SmartEVSE/smartevse/pictures/smartevse_cli_ttl_cable.jpg

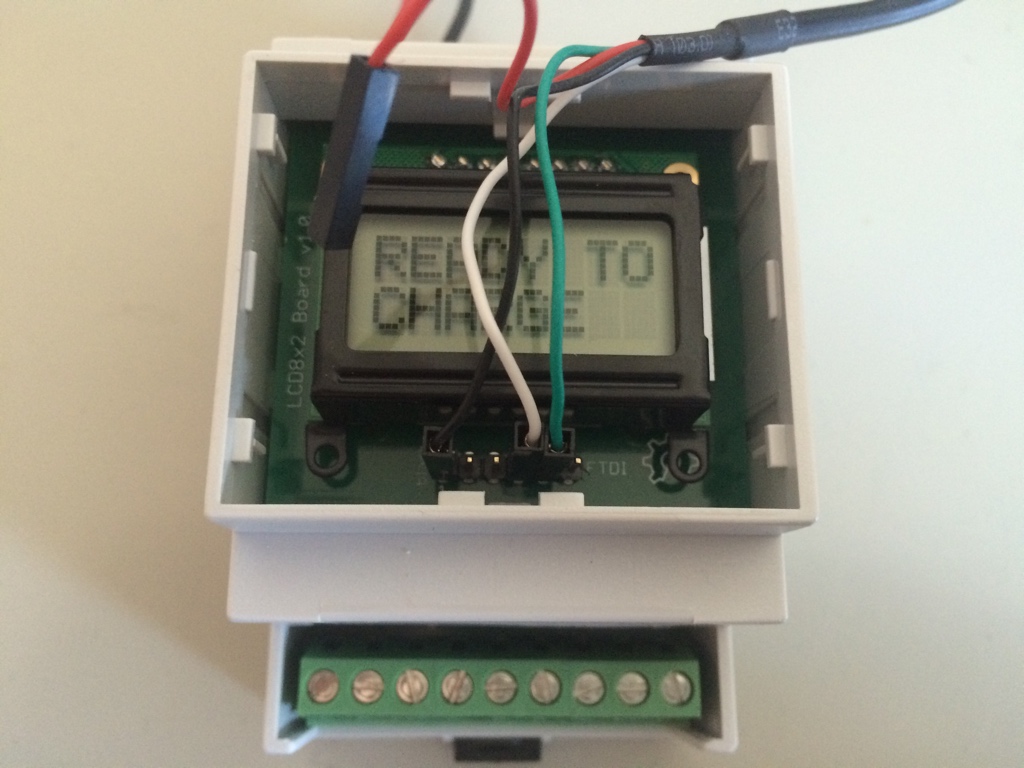
pictures/smartevse_cli_ttl_cable.jpg
