SmartEVSE/smartevse/pictures/EVSE_enclosure.jpg

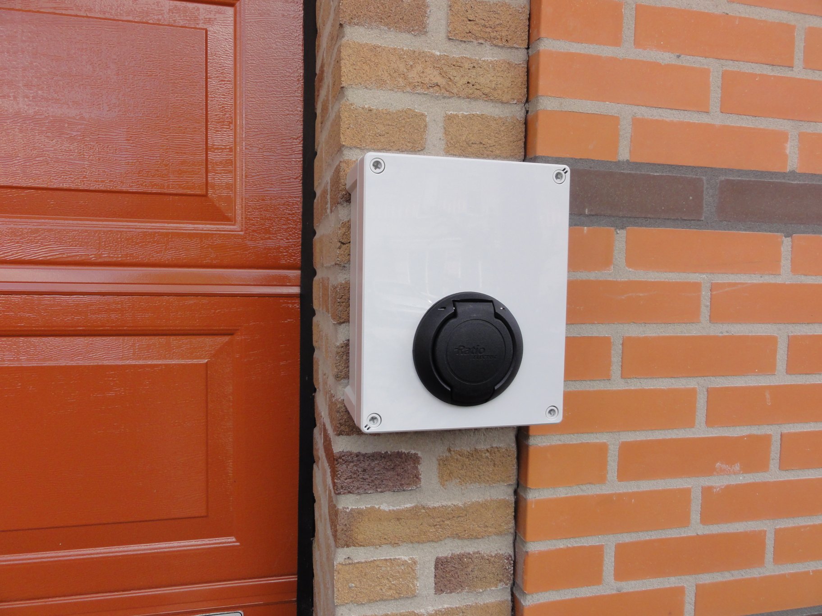
pictures/EVSE_enclosure.jpg
