SmartEVSE/smartevse/README.md

SmartEVSE v1
=========

This repository is now for the older v1 of the module only.
All developement for the current version v2 of the module is taking place here:
[SmartEVSE-2](https://github.com/SmartEVSE/SmartEVSE-2)
