SmartEVSE/smartevse/version2/README.md

SmartEVSE v2
=========

Version 2 uses a PIC 18F26K22 microcontroller, Graphic 128x64 LCD.
for compiling, MPLAB X IDE is used together with the XC8 compiler.

set XC8 linker memory model settings to: double 32 bit, float 32 bit
    extended instruction set is not used on XC8
	
- SmartEVSE2.X folder contains the sourcecode for the PIC microcontroller
- eagle folder holds the pcb layouts (eagle 6.6)
- manual folder has the latest manual.
