SmartEVSE/smartevse/pictures/1Phase_Charging26A.jpg

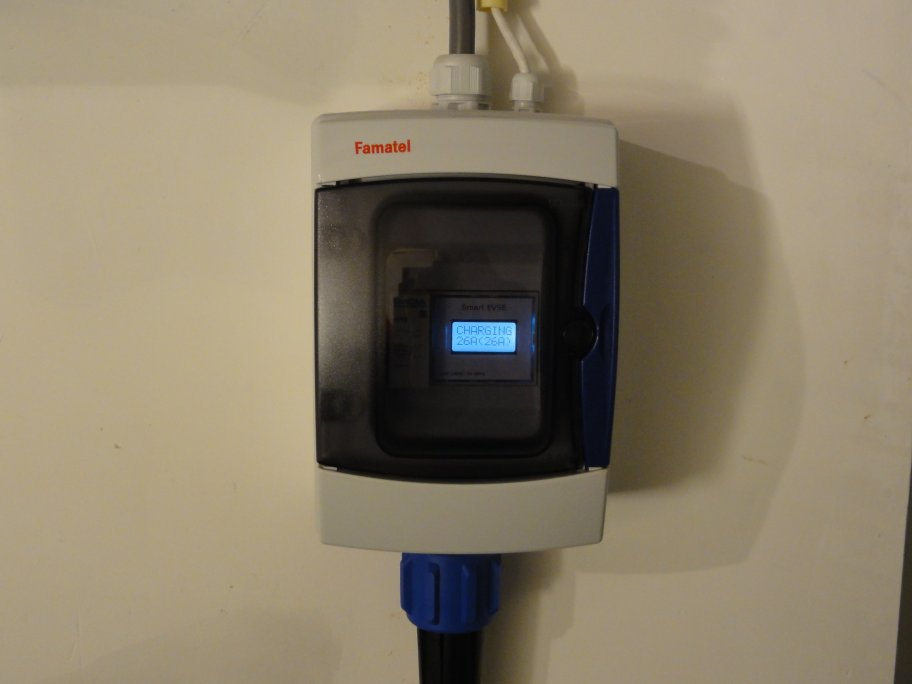
pictures/1Phase_Charging26A.jpg
