SmartEVSE/smartevse/pictures/1Phase_ChargingL123.jpg

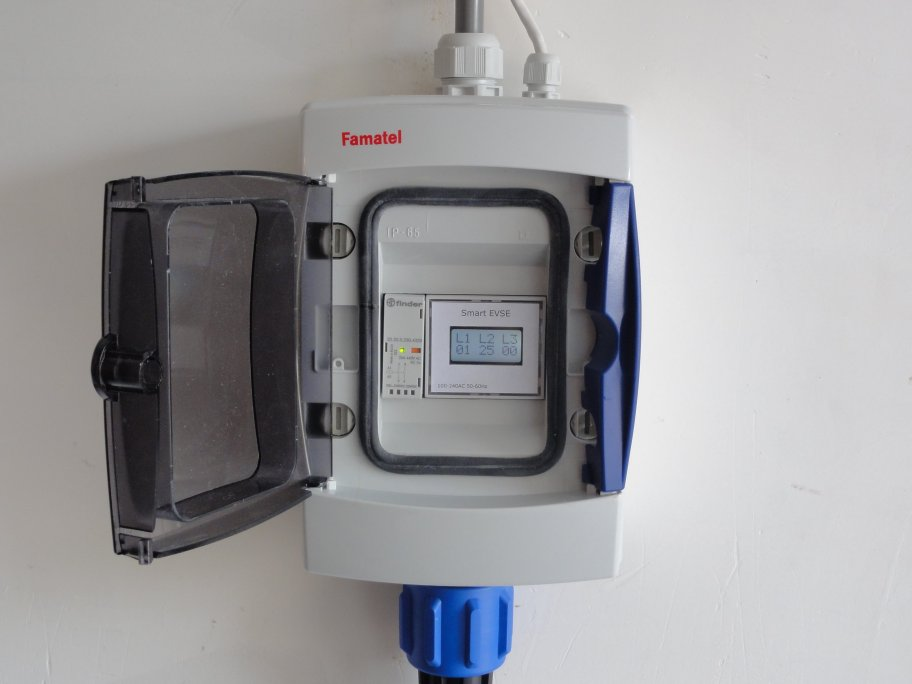
pictures/1Phase_ChargingL123.jpg
