SmartEVSE/smartevse/pictures/EVSE_enclosure_opened.jpg

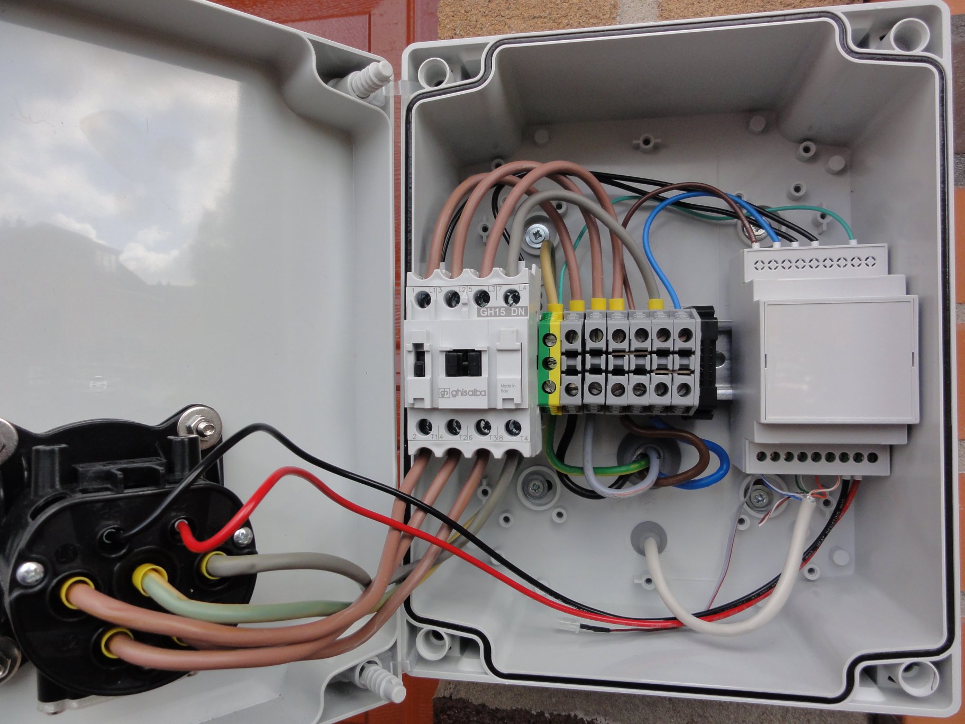
pictures/EVSE_enclosure_opened.jpg
