SmartEVSE/smartevse/pictures/LCD_menu.jpg

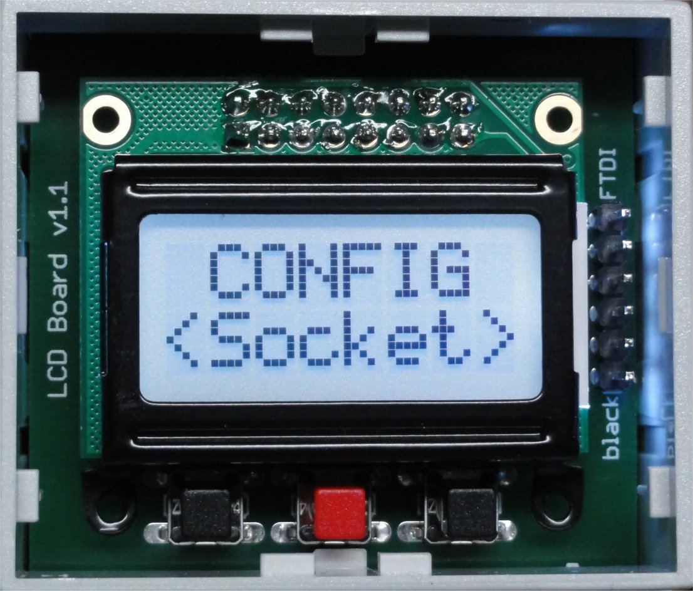
pictures/LCD_menu.jpg
