SmartEVSE/smartevse/pictures/sensorbox_opened.jpg

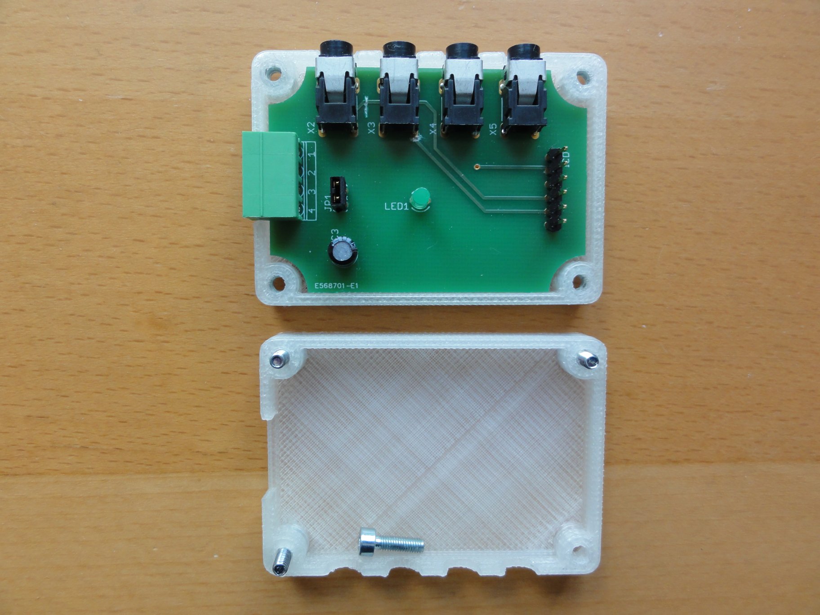
pictures/sensorbox_opened.jpg
