SmartEVSE/smartevse/pictures/smartevse_cli.png

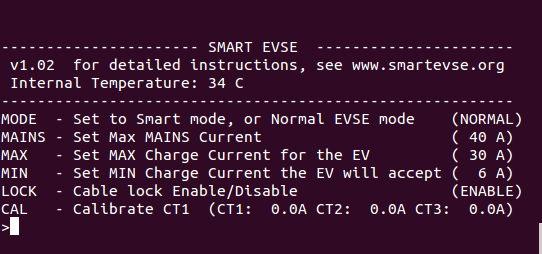
pictures/smartevse_cli.png
