SmartEVSE/smartevse/pictures/SmartEVSE_DIN.jpg

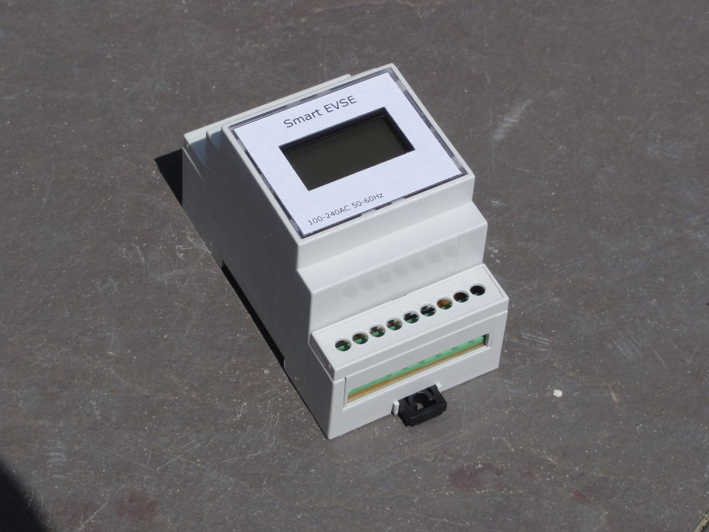
pictures/SmartEVSE_DIN.jpg
