SmartEVSE/smartevse/pictures/SmartEVSE_PCBa.jpg

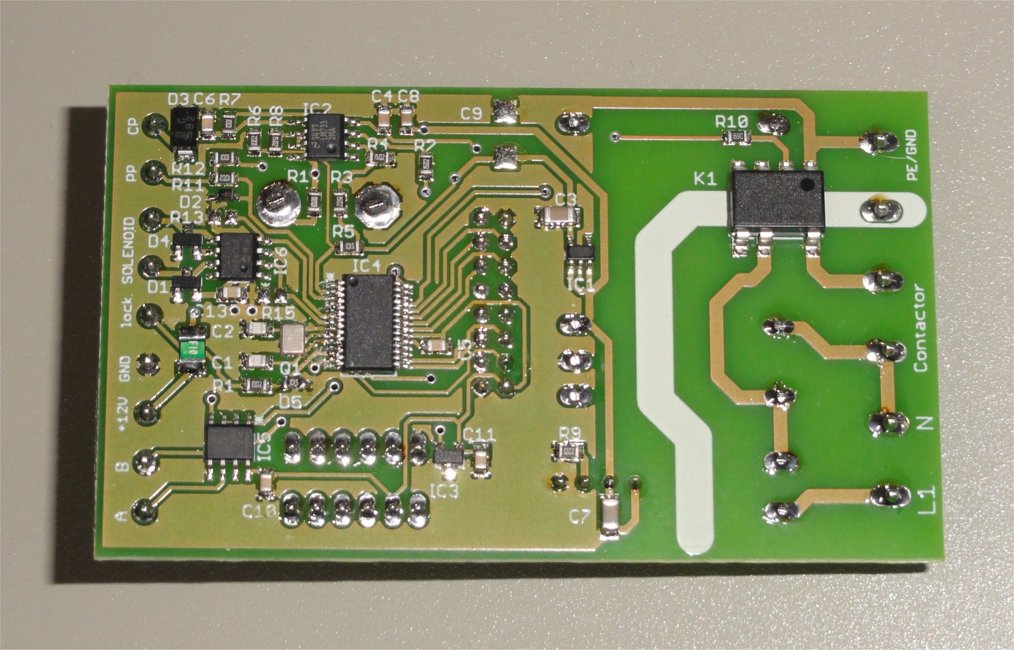
pictures/SmartEVSE_PCBa.jpg
