SmartEVSE/smartevse/pictures/SmartEVSE_PCBb.jpg

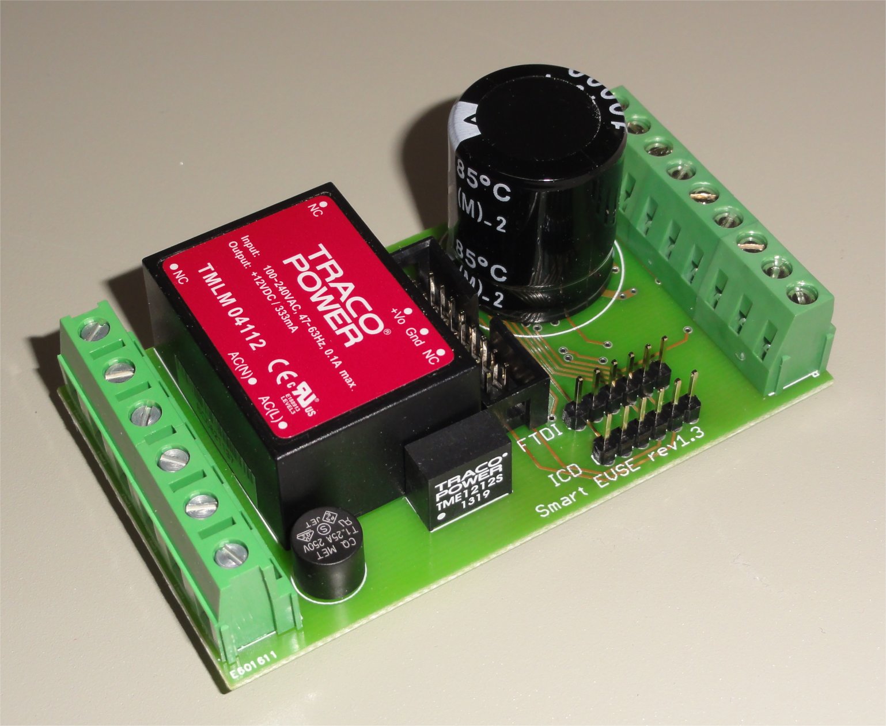
pictures/SmartEVSE_PCBb.jpg
