SmartEVSE/smartevse/pictures/SmartEVSEv2_small.jpg

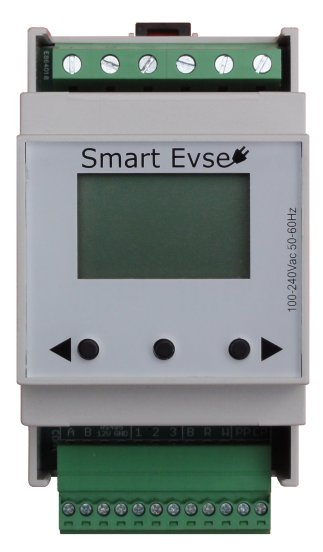
pictures/SmartEVSEv2_small.jpg
