SmartEVSE/smartevse/cad/Sensorbox2.stl

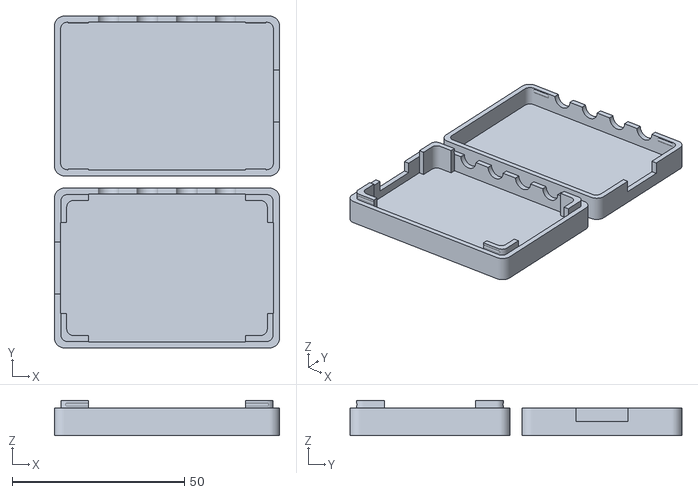
[picture p13: CAD file, 2017-08-28]
cad/Sensorbox2.stl
65.5 x 96.5 x 10.2
