SmartEVSE/smartevse/(list of files, cad)

Other CAD files:
cad/polyholes.scad
cad/teardrops.scad
