SmartEVSE/smartevse/pictures/wiring_diagram_1phase.jpg

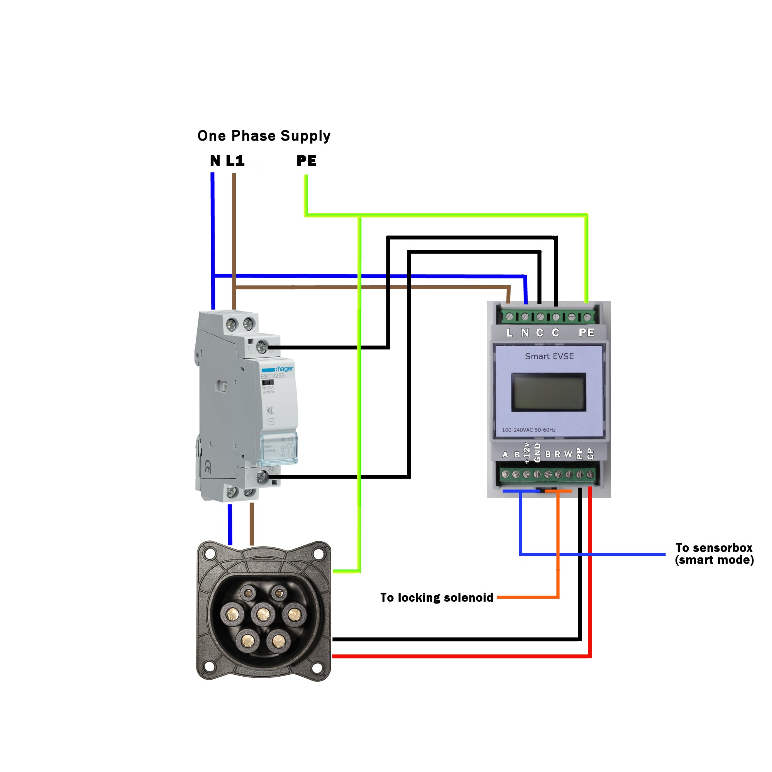
pictures/wiring_diagram_1phase.jpg
