SmartEVSE/smartevse/pictures/wiring_diagram_3phase.jpg

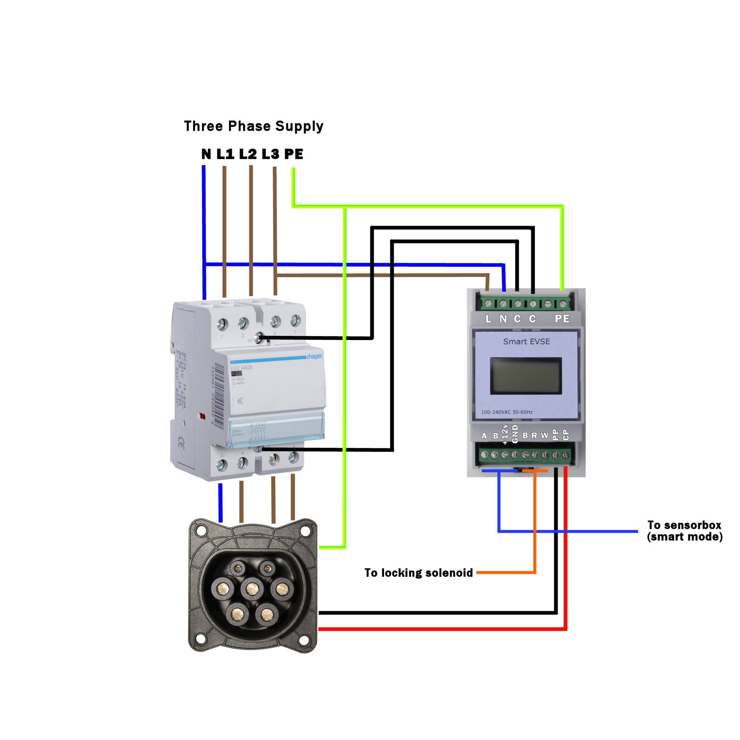
pictures/wiring_diagram_3phase.jpg
