SmartEVSE/smartevse/(threads)

Thread 1 (2015-11-16):

OCPP Implementation

goRaspy, 2015-11-16:
Hi,

Your works is great ! Did you already thought about implementation of "open charge point protocol" for smart EVSE ?

Regards,

wido, 2015-12-18:
No, not really. I think nobody started any work on this.

It might be really simple that a additional controller simply sets a pin to high and if that pin is low no charging is allowed.

tho-wa, 2016-05-09:
Yes that's a great idea, then the SmartEVSE could also be used for public charging.
There are multiple billing service providers that are compatible to OCCP.

wido, 2018-11-05:
I think that #9 would help with this. I'm closing this one right now as when #9 is implemented people could add their external auth to SmartEVSE.

Closed 2018-11-05.

Thread 2 (2015-12-25):

Control charge current by solar power

tho-wa, 2015-12-25:
Is it possible to change the smart mode this way that it would be possible to measure power of solar system/photovoltaic with the sensor box and control the charge current based on the pv power output?

wido, 2015-12-25:
In theorie it is possible. The sensor box just sends the values of how many Amps each phase is using. If you fake the input into the EVSE with something that comes from your PV array you could do that.

tho-wa, 2015-12-30:
The sensor can be put on the PV AC cable after inverter or before main meter of the house so the PV power can be messurred. There is only an additional option needed in CLI  and extension of the code, so that the charging current is calculated by PV power.

tho-wa, 2016-02-01:
Does the sensorbox measure energy flow in both direction, or only in one direction?

mstegen, 2016-02-23:
The sensorbox can not detect the direction of flow of current. So it can not tell the difference between a load or your PV system generating power.

The RS485 connection between module and sensorbox uses the same protocol SMA is using on their inverters. So if you have a SMA inverter (and RS485 piggyback), you should be able to read the generated Power by modifying the code.

ljfaragher, 2016-10-09:
Tho-wa
Did you get smart evse controled by excess solar pv. Thus us exactly what I want to do.

jackdwest, 2017-04-06:
I am using the Smart to control charging using excess PV.  My system is off grid and I measure the DC current from the array using CT4 input and a shunt instead of CT.  This was fairly straight forward to implement.  It would be very similar to implement with an AC array too using CT3.

Closed 2018-03-11.

Thread 3 (2015-12-30):

Display only charging current if MODE is normal.

tho-wa, 2015-12-30:
In normal mode only MAX_CURRENT should be shown on the display, MAX_MAINS is not needed and might confuse the user.

wido, 2016-01-05:
If somebody wants to implement this it would be nice! Don't know if anybody wants to spent time on it.

mstegen, 2016-02-23:
This was fixed at version 1.04

Closed 2016-02-23.

Thread 4 (2015-12-30):

cable not unlocked if charging is stopped - renault zoe

tho-wa, 2015-12-30:
When I use the remote to stop charging and disconnect the cable from the car, SmartEVSE seems not to unlock Type2. If the car is fully charged, Typ2 gehts unlocked. Is this behavoiur known?

tho-wa, 2015-12-31:
I use DSIEC-ELB https://evconnectors.com/pdf/DSIEC-M-ELB-EV16S-XXC.pdf
It locks the Typ2 Connector when I disconnect the cable from car.
When I connect the cable, nothing happens....

tho-wa, 2015-12-31:
Red and white must be changed in case of DSIEC-ELB lock.

 Issue can be closed.

Closed 2015-12-31.

Thread 7 (2018-04-24):

Minimum max mains current is too high

xalerius, 2018-04-24:
The lowest mains current that can be set is currently 25A. Is there a reason for this? In Sweden 16A mains is quite common.

wido, 2018-04-24:
In the Netherlands (where it was developed) 25A is the default, so that's where it probably came from

xalerius, 2018-04-25:
Ok that makes sense, well then I guess it should be possible to change to a lower value. I tried to make that change myself yesterday, but when I try to run my code I get garbage characters on the display (and in the serial interface). If I enter the menu (by pressing the middle button) I get normal text, but as when I exit the menu I get garbage instead of "READY TO CHARGE". I have tried to just build a version without any changes and get the same behaviour so it seems there is something wrong with my environment. Anyone else had this problem? I have a v2 board, tried to build under both windows and linux, same result.

lordprize, 2018-04-26:
I have changed this for a single SmartEVSE at the request of a friend just a few days ago. If more people need it, perhaps the change can be implemented in the official software. Perhaps a value even lower than 16A would be OK (e.g. 11A - one more than the minimal MaxCurrent).

Elektrofix-OL, 2018-05-13:
I‘ve the same problem. The mains current need to be less the 16A.
I try to built a neu firmware, but the compiler needs someone files:
„xc.h“
„stdio.h“
„stdlib.h“
„math.h“
and I didn‘t find them. Where is my mistake?

mstegen, 2018-05-16:
Sorry for the delay. I just changed the lowest MaxMains setting to 10A in version 2.03.
Had to change the CLI limits as well.

lordprize, 2018-05-16:
Perfect - thank you, Michael!

Elektrofix-OL, 2018-05-16:
Thanks, my charging station at work is now completely finished. The charging station fuse will no longer trip. [https://www.goingelectric.de/forum/ladeequipment/ein-ladepilz-entsteht-t31485.html#p736339](url)

There ist a mistake while the smart mode: wenn L2 or L3 be on limit, but L1 has enough space, the EVSE doesn't switch on. That isn't nice, because the EV get no power.
Perhaps it is possible to start changing without looking on L2 and L3 for th first 5 secons?
There are a lot of EV witch use only L1 in Germany. EV whitch use L1-L3 are not so often.

mstegen, 2018-05-17:
SmartEVSE needs atleast 6A of room to start charging. (as that's the lowest charge current it can set) If any of the phases is higher then MaxMains-6A, then it will not start. That's implemented for security.
Unfortunately there is no way for the EVSE to know if the connected EV will only charge at one phase, or if all phases will be used.

You could always change the code yourself, or disconnect L2 and L3, on both the contactor and sensorbox, so that it will charge at one phase only.

mstegen, 2018-05-17:
I have tried to reproduce the problem, but did not see any issues.
I measured the PWM duty-cycle of the CP signal, and it's 26,6% as it should be at 16A.

A possible explanation could be that you compiled the sourcecode yourself. I noticed that some new compiler versions will complain a lot. There might be wrong code generated at the SetCurrent function.
The default duty cycle is then set to 10% which is 6A.

Please try to flash the hex file in /version2/SmartEVSE2.X/dist/default/production/

Thread 9 (2018-07-11):

Use IO for authorization

ErnieV, 2018-07-11:
Getting a signal on I/O port opens a window of 1 minute to start charging program, otherwise charging is not allowed. Gives user possibility to implement any form of authorization like hidden button, NFC/RFID reader or remote control by webserver.
As optional feature (menu item).

arjannv, 2018-11-30:
I like the idea and would like to help programming this.
Maybe it's a good idea to, for instance set I/O:
I/O 1: High
I/O 2: Read for access control
I/O 3: High when charging is possible

The access control circuit then needs to provide a potential free contact to I/O 1 and 2 for access control. In this way, there is no hassle with grounding, overload protection etc.

I/O 3 can be used to create a switching contact near the Smart EVSE. With this switching contact a Red/Green LED can be powered near the connector.

A few questions:
- Which ports are used for I/O 1, 2 and 3?
- Is there a way to get a High signal without using the precious I/O 1 port for this?
- Can I use the Timer variable (mSec) for the 1 minute of access? This needs to incorporate a function for the overflow of-course

mstegen, 2019-02-20:
Software version 2.04+

I have now added support for authorization with a (momentary) switch on IO2 (SW on hardware 2.1)
One pulse to ground, and access is enabled, another pulse will disable the EVSE (and also stop charging)

You can enable this feature in the (LCD) menu of the SmartEVSE, the feature is called ACCESS.
When set to Disable, a (push)button on IO2 will still function as a STOP button, to be able to stop the EV from charging.
You will have 15 seconds to remove the cable. After 15 seconds the charging will continue, and cable is locked again.

On hardware version 2.1, IO1 is now used to drive a 12V led. It will fade in and out when charging.

IO3 will be used to connect to a residual current monitor device, to detect AC/DC fault currents.
This will come very soon in a future update.

arjannv, 2019-02-20:
Thanks for the update!

I thought so already while browsing the menu of my SmartEVSE :)
Also spotted the new IO notes.

How is this switch connected? Is IO2 reading for a 12V input?

Can this also be used to schedule the charging? Waiting for the off-peak hours?

I've got my SmartEVSE up and running now. Only need to test the ACCESS part with a Raspberry Pi reading for RFID tags and familiar Bluetooth devices.

mstegen, 2019-02-20:
Schedule the charging is tricky, as there is no real time clock in the SmartEVSE.
So it does not know what time it is.
The 16Mhz xtal could be used as time reference, but not sure what the time drift would be.
I think it's better to schedule the charging from the EV. (if your car supports it)

Plugging in the car and then at a specific time enabling access to the SmartEVSE (with the Raspberry Pi) would give you scheduled charging.
Btw, That's a nice idea, ref the familiar Bluetooth devices!

arjannv, 2019-02-21:
Ah yes, timing with the Raspberry Pi I meant :)

Regarding the Bluetooth idea:
I came across this thread: https://www.raspberrypi.org/forums/viewtopic.php?f=37&t=47466
It shows how to connect to the (known) Bluetooth device and read the signal strength. In this way, you can authorize the charging only when the Bluetooth device is very near.

spikerm, 2019-03-25:
I managed to get a fingerprint sensor working as acces device :)

question when the car is disconnected and acces is enabled in the software does the cable keeps locked until right acces key is given ?
so the cable keeps locked in the charger

mstegen, 2019-03-26:
Nice that you got a fingerprint sensor to work!

The current software always unlocks the cable from the socket, once the charging is stopped.
Maybe an idea for a future feature?

pascalsaul, 2020-07-17:
@spikerm @mstegen Could you share and update the documentation which components we need to buy and how to wire to add the new access (un)lock funtion?

mstegen, 2020-07-26:
You'll need a stand alone RFID reader, one that works with mifare cards (13.56 Mhz), and has a relay output. And can be learned to recognize your charge card.
Usually these relay outputs will switch on for a short period of time, and then switch off again (pulsed output).
Connect the relay to the SW and GND pins on the SmartESVE, and set the SWITCH option in the menu to ACCESS B (for button).

Now when you swipe your card , the smartESVE can be switched from ACCESS DENIED, to READY TO CHARGE. and vice versa.

pascalsaul, 2020-12-26:
I got it working with a rewritten ESPeasy module but I didn't like the implementation. In the meantime I use a Sonoff Basic with Tasmota where I cut off the 230V and just have a stupid relay. The Sonoff is configured as a Pulse button for 0,5 second. This combination I'm using together with OVMS to stop charging at 80% now through Home-Assistant.

pascalsaul, 2021-01-14:
@ErnieV I think this issue can be closed now :)

Thread 10 (2018-08-25):

MAINS setting limits current also in Normal mode

JosDeGraeve, 2018-08-25:
When the Smart Evse is in "MODE Normal", the EV will not charge upto the MAX current set value, if the MAINS set value is lower than the MAX set Value.

Environment:
Smart EVSE is connected to single phase 230V 32A rated wiring, charged vehicle is Tesla Model S 75D facelift model with high capacity charger.  Charger cable is rated to 3F 32A - socket connection.  Smart mode is turned off - no current clamps connected.

Steps to reproduce
* Enter menu
* Set MODE to Smart.
* Set MAINS value to 25A ( is this also not the default ? )
* Set Mode to Normal
* MAINS setting is no longer visible in the MENU
* Set MAX setting to 32A
* Connect Charger to Car and start charging

Observed behaviour
* Car charges at 25A instead of at 32A
* Setting the max current in the car is not possible, it is fixed at max 25A

Expected behaviour
* Car charges at 32A when SmartEVSE is in mode Normal with MAX set to 32A
* Because the MAINS setting is only visible in Smart mode it is not logical for it to have any effect when not in Smart mode.

Current issue Workaround:
* Enter SmartEVSE menu
* Set Mode to Smart
* Set MAINS value to 32A
* Set Mode to Normal
* Set MAX value to 32A
=> Car charges at 32A

This issue had me searching for quite a while why my Tesla did not charge upto 32A.  It's only when Tesla Service notified me that my charger had a pilot signal for 25A when i expected it to have a pilot signal for 32A.

I found the workaround above but others might be affected by this issue as well.

Kind regards and tnx for this great project !

mstegen, 2018-09-25:
Thanks for your detailed issue report.
I have fixed this in the next version, will be uploaded in a few days.

Closed 2018-11-05.

Thread 11 (2018-08-28):

SmartEVSE 2.03 only charging at 6A in normal mode

jonasf21, 2018-08-28:
SmartEVSE 2.03 is only charging at 6A in normal mode.

Settings: normal mode
MAX: 32A (or 25A, doesnt matter)
No Load Balacing

Effect: Car (Tesla Model S) is only charging at 6A, cant change it in the car.
SmartEVSE is still reporting 32A max, shows charging 6A on display.

I have flashed older 2.02 firmware and the issue is not happening there.

Someone already reported this problem in a different issue:
https://github.com/SmartEVSE/smartevse/issues/7

jonasf21, 2018-08-29:
I just updated from 2.02 to 2.03 again (as Michael suggest) and it now works - i had to disconnect the charging cable from both socket and car and replug (it was showing max. 6A again) - then it worked with more than 6A. Not sure if Telsa cached the max. current somewhere or whatever....

Closed 2018-08-29.

Thread 14 (2018-12-15):

Loadbalancing not working as expected with mixed 1 and 3 phase cars

barteld, 2018-12-15:
The current loadbalancing algorithm only takes into account the current, and not the number of phases the cars can charge at. This leads to cars waiting to get charged while enough power is available.
To further explain: I have a ZOE (that can handle up to 3x64A) and have ordered a Niro. The Niro has a single-phase charger and will be charged through a transformer (https://www.ratio.nl/nl/catalog/e-mobility/ev-transformer-laadstation/ev-transformer-laadstation/37300/groups/g+c+a+nr+view).

Now when the Niro is charging the ZOE has to wait until it has completely finished as the maximum current of my charging group is 3X16A. This is a bit of a waste as the ZOE can charge just fine at 1X16A while the Niro uses 2X16A. All in all this means that the total charging time for both cars goes up from 10hrs to 15 hrs from almost emprty.

I understand that this is not an easy one to fix as the PWM signal only allows for the current to be set, and cannot be used to instruct the car to only use a specific phase (as far as I know, didn't read the whole specification).

However there is a workaround possible if using fixed cables. In that case we can use a second contactor wired up (with a 12v relais) to the LOCK output. We can reconfigure this output to shut of 2 out of three phases when in loadbalancing mode. In this case the Niro uses for instance L1 and L2 to charge while the ZOE uses only L3 when the Niro is charging and L1, L2 and L3 when it's the only one.

This will work for up to three cars. The cleanest possible solution would be for evse to be able to monitor all phases and share info about which phases are used but in my opinion evse should be kept as simple as possible. The main target for evse is home charging but it should be able to handle the various chargers as a lot of cars go on the market now with just single phase support.

I have created a version of evse that does this, however it is not to be used as it is not tested and it's my first go at embedded programming. I will share it in the comments but regard it as a POI (proof of idea) rather than something that is to be used.

barteld, 2018-12-15:
Here's the code changes:
https://github.com/SmartEVSE/smartevse/compare/master...barteld:Phase_based_loadbalancing?expand=1

And a link to the repo:
https://github.com/barteld/smartevse/tree/Phase_based_loadbalancing

ankowolf, 2019-01-04:
This is exactly what I aim at doing. In my case it will be a car with a 1x32a OBC (Opel Ampera E) and car with a 3x24a OBC (Tesla). When the Opel is charging, the Tesla can charge on 2 phases. When the Opel is not charging the Tesla can charge on 3 phases.

Have the same idea with the additional contactor.

But have the same issue that the first module must take into account the load on L1 where the second module must take into account the load on L2 + L3 (and optionally L1).

As I didn't want to lean how to program the module, I decided to implement my own master on a RPI Zero with an RS485 interface and use two modules, both in Slave mode.

Getting there, but the result is not stable. For example, both slaves switch from Charging State to State A when they receive a broadcast message from the master that advertises 7 amps current for either one of the slaves. Same with 11 amps. As if they don't like 7 and 11.

Rings a bell?

evhaandel, 2019-01-11:
Hi @barteld ,

You're mentioning that you will use the SmartEVSE in combination with EV Transformer Charging Station from Ratio Electric to charge a Kia e-Niro. When will you receive your e-Niro? I'm very interested in your experiences with this charging combination. Can you contact me via my Github profile?

Thanks,
Emiel

arwooldridge, 2019-08-31:
@barteld If I understand you correctly this will not work, the three phase to single phase transformer cannot be fed from only two of the three phases, if so it would either produce too high a voltage or too low depending which phase was missing. In any case the three phase to single phase transformer arrangement ( wye in wye out) is not fully balanced and no transformer only arrangement can be balanced, only an inverter solution. Why not just limit the charging current from inside the EV's.
Depending on the specification of the 3phase to single phase transformer you could possibly take both single phase supplies from that ( again limiting the current in each EV to suit). Beware though that the 3Ph to 1Ph transformer setup. apart from not balanced, is also not very efficient due to winding losses and magnetic losses. Actually a difficult problem to solve neatly unless you eliminate the 3ph to 1ph transformer setupcompletely, and charge direct off 2 phases for Niro and one phase for Zoe, perhaps that is what you are trying to do?

AlbertHakvoort, 2019-12-17:
> Had a little coding issue in my RPI based slave. Escaping of characters was not done properly. Fixed that and now it seems stable.

Hi Anko, would you  like to share the code of the modbus master script?

Thread 18 (2019-07-22):

Measure kWh charged

HeNRGi, 2019-07-22:
It would be great to have a measurement of kWh charged in the SmartEVSE itself.

Could it be as simple as multiplying the AC current, multiplied by the number of phases used by the car, multiplied by the AC voltage (230V in NL), multiplied by the duration of interval this calculation is done (e.g. 5 seconds, a 5 seconds interval timer based on the oscillator in the SmartEVSE)? Then add this to cumulative watthour counter?

Accuracy may vary, based on measurement sources, e.g.
LOW - based on the current setting that was sent to the EV
HIGH - current measured via a (secondary) sensor box with CT sensor(s)

Is there even a need to correct the power values with the typical/average cos phi factor of a particular car?

N.B. In e.g. The Netherlands, MID compliance is NOT needed for kWh measurement data for tax purposes (contrary to what many people seem to believe), according to the legal department of the Dutch Tax and Customs Administration. To me this raises the question whether bothering with the complexity of sampling both current and voltage with a frequency >> 50Hz, as is done in e.g. [http://ww1.microchip.com/downloads/en/AppNotes/00939a.pdf](url) and in e.g. [https://github.com/openenergymonitor/EmonLib/blob/master/EmonLib.cpp](url) is even needed; I suspect a LOW measurement accuracy suffices.

|

bobosch, 2019-07-23:
Yes, this is on the todo list.

But it would not be very precise.
First, a phase detection is needed. Many cars charging with one phase, many with three...
Also the internal timer is not very precise. And if the sensorbox allows 32 A charging current, and the car supports only 16 A, this won't be recognized by the smartEVSE. (this error could be reduced by only allowing 16 A...)

A second sensorbox would be more precise, but currently it is not possible to use two sensorbox because they have a fixed address.

Supporting an electric meter would be easy - but then you can just as well take a look at the display of the electric meter.

HeNRGi, 2019-07-23:
Based on the discussion over at [Tweakers (in Dutch)](https://gathering.tweakers.net/forum/view_message/59498712), it became clear to me that kWh measurement based on the current setting sent to the EV might grossly overestimate the amount of electiricity used to charge; an EV is free to choose any current lower than the maximum it gets from the SmartEVSE, and towards the end of the charging session, almost certainly does so.

So, it seems an approach is needed that measures voltages and currents multiple times per second (say 400) similar to the way it is done in the [OpenEnergy Monitor EmonLib](https://github.com/openenergymonitor/EmonLib/blob/master/EmonLib.cpp#L66), which seems quite similar to [Application Note 939 by Microchip](http://ww1.microchip.com/downloads/en/AppNotes/00939a.pdf), the maker of the PIC microcontroller used in SmartEVSE.

In the Netherlands, I suppose a smart meter's P1-port could be used to measure the mains power drawn of the total home, potentially freeing up the CTs and the SmartEVSE sensorbox to be retargeted towards measuring the cumulative energy spent towards charging the EV?

For Tesla EVs, another software-only approach that seems to be feasible, is using the (reverse engineered) Tesla API to repeatedly poll for the parameter charge_energy_added via the [GET charge-state endpoint of the Tesla car](https://www.teslaapi.io/vehicles/state-and-settings#charge-state). The paid TeslaFi service is based on this Tesla API and provides the info I need. In the Netherlands, the free [Jedlix service](https://jedlix.com/en/) also uses this Tesla API, but I am unsure whether they track kWh charged as well. Moreover, the Tesla API is not a properly supported API that allows 3rd parties scoped access and repeatedly polling the car seems wasteful...

pascalsaul, 2020-07-17:
There is an integration with the SDM630 meters all ready . Is it possible to use those meters to measure the charged KWH's? I've put on off those in the chargebox to measure now.  Instead of using it for the "MAINSMET" use it as "CHARGEMET?

The question is now how good the internal memory is to save the loading sessions over time and how long can the history be?

bobosch, 2020-11-25:
Implemented with commit 67f4163fd47fb145e410594e7d08d794d4de31b3 - no history, only last charge

Closed 2020-11-25.

Thread 19 (2019-08-02):

It doesn't change the power when "smart" Mode

LolDeibid, 2019-08-02:
Hi all,

I hope you can help me. I will try to explain my issue as best as i can (not native english).

Today i finished to set up my "DIY Wallbox" with SmartEVSE and SensorBox. All fine, the sensorbox catch up all the consumption at home and i can see printed on the display when "Smart" mode is ON.

I've 230v@20a at home, single phase. At "MAINS" option i setted 20a, MAX 20a and MIN 10a. I've fixed cable so i setted on this at 20a as i builded it with 4mm² cable.

The issue is that i can connect my microwave, toaster, computer and some lights, see on screen L1 - 11 (i understand 11a??), but still charging at 20a (Charging 20a (20a) at screen).

Am i failing with setup? Here you have my actual setup:

MODE -> Smart
MAINS ->20a
MAX -> 20a
MIN-> 10a
Cable ->20a
CAL-> 01.1a (can't modify)
Access-> Disabled
RCMON->Disabled

Thanks a lot!

mstegen, 2019-08-19:
The display shows the total current measured , if it displays L1: 11, then it measures 11A on the phase.
When starting to charge, it will display the max charge current you set (20A), at the moment the car is actually drawing current the L1 measurement should increase.
When the total current measured on L1 is higher then 20A (MAINS setting) it will start to lower the charging current to the EV.
The EV will react to this within a few seconds, so that the maximum current on L1 should stabilize at 20A.

LolDeibid, 2019-08-19:
Mmmm if I understand it, i should add the sensorbox at main phase BEFORE the charger to measure all consumption, house and car, together? Actually i've connected after the car, so it "reads" only the house, as other chargers works like this.

Is it right? I will test this afternoon.

Kind regards,

David.

mstegen, 2019-08-19:
Yes exactly, the sensorbox and CT sensor, should be able to measure ALL current, including the car.

By doing this, it knows exactly when to start reducing the current to the car, with only one sensor.

Closed 2020-08-20.

Thread 20 (2019-11-02):

Add Solar PV control input to vary Charging current

arwooldridge, 2019-11-02:
On tethered units ( most home chargers?) the PP analogue input is unused, so could be used for proportionally controlling charging current depending on Solar PV power available. The variable voltage control could be from the Solar PV inverter if available, or from a mini, resistive loaded, solar cell to mimic the Solar PV, or from a directional energy monitor sensing excess PV power over consumer load. zappy style.
For example something like
    if (Config) {      // Override when Fixed Cable is used but use PP input for variable control instead
       //MaxCapacity = CableLimit;
	MaxCapacity = 16*ADRES/1024;   //Most PV systems  are 4KW so 16 A max
	if(MaxCapacity>CableLimit) MaxCapacity=CableLimit;
	}
A simple switch could override analogue i/p to max if you need to charge with no sun.
use a pullup on PP input if facility not required or add menu item to disable variable charging.

arwooldridge, 2019-11-20:
Refined the code and tested OK Tesla mode and non Tesla mode.
Forked new repository at https://github.com/arwooldridge/smartevse_variablePV and switch to the smartevse_VariablePV branch
Works on PP input with Solar cell 53x30mm loaded with 60 ohm or analogue input from PV inverter or directional energy monitor ( scale to suit 3.3v max PP input) or variable pot or switched resistors to 0 volts
Select 5A in Mincurrent menu to get 5A tesla charging mode ( Tesla charging will stay in state C at zero current if DutyCycle drops below 82)  else reverts to non Tesla charging for Mincurrent 6A or more.

arwooldridge, 2019-11-27:
Some different ways to use the PP input for variable charging.
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

Thread 21 (2019-11-14):

Xtal frequency

maximevince, 2019-11-14:
Hi there,

First of all, congrats on the great work.
Second, I'd like to know what the Xtal frequency is that you're using for the PIC.
From the code comments, I am assuming it's 16 MHz, is that correct?
It's not annotated in the schematics.

Thanks,
Maxime

mstegen, 2019-11-15:
Thanks.
Yes it's running at 16Mhz, the PLL is currently not used.

maximevince, 2019-11-15:
Thanks for specifying!

Closed 2019-11-15.

Thread 22 (2020-01-05):

P1 data from Landis+Gyr e360 Sigle phase

Fjuxx, 2020-01-05:
I discovered that there is a problem with the Sensorbox 2 with a Landis+Gyr e360 smart meter when using a single phase.

the smart evse seems to not balance the load at all even when it is exceeding the set mains limit.
when the CT clips are connected it does work as expected.

I've enabled debug rows 2232 and 2233 and uploaded the new firmware to the smart evse to see what is happening.

here is a log of everything with the P1 data:
````
STATE: A Error: 2 StartCurrent: -4 ImeasuredNegative: 0.0 A ChargeDelay: 0 SolarStopTimer: 0 NoCurrent: 0 Imeas: 0.0 A IsetBalanced: 21.0 A L1: 6.8 A L2: 34028235080000000000000000000000000000.0 A L3: 34028235080000000000000000000000000000.0 A Isum: 6.8 A
Cable limit: 16A  Max: 16A
STATE A->B
STATE: B Error: 0 StartCurrent: -4 ImeasuredNegative: 0.0 A ChargeDelay: 0 SolarStopTimer: 0 NoCurrent: 0 Imeas: 0.0 A IsetBalanced: 26.0 A L1: 6.8 A L2: 34028235080000000000000000000000000000.0 A L3: 34028235080000000000000000000000000000.0 A Isum: 6.8 A
Imeasured:0.0 A IsetBalanced:16.0 A Baseload:0.0 A EVSE0[2]:16.0 A EVSE1[0]:0.0 A EVSE2[0]:0.0 A EVSE3[0]:0.0 A
STATE B->C
Imeasured:0.0 A IsetBalanced:16.0 A Baseload:0.0 A EVSE0[2]:16.0 A EVSE1[0]:0.0 A EVSE2[0]:0.0 A EVSE3[0]:0.0 A
STATE: C Error: 0 StartCurrent: -4 ImeasuredNegative: 0.0 A ChargeDelay: 0 SolarStopTimer: 0 NoCurrent: 0 Imeas: 0.0 A IsetBalanced: 16.0 A L1: 6.9 A L2: 34028235080000000000000000000000000000.0 A L3: 34028235080000000000000000000000000000.0 A Isum: 6.9 A
Imeasured:0.0 A IsetBalanced:16.0 A Baseload:0.0 A EVSE0[2]:16.0 A EVSE1[0]:0.0 A EVSE2[0]:0.0 A EVSE3[0]:0.0 A
STATE: C Error: 0 StartCurrent: -4 ImeasuredNegative: 0.0 A ChargeDelay: 0 SolarStopTimer: 0 NoCurrent: 0 Imeas: 0.0 A IsetBalanced: 16.0 A L1: 7.1 A L2: 34028235080000000000000000000000000000.0 A L3: 34028235080000000000000000000000000000.0 A Isum: 7.1 A
Imeasured:0.0 A IsetBalanced:16.0 A Baseload:0.0 A EVSE0[2]:16.0 A EVSE1[0]:0.0 A EVSE2[0]:0.0 A EVSE3[0]:0.0 A
STATE: C Error: 0 StartCurrent: -4 ImeasuredNegative: 0.0 A ChargeDelay: 0 SolarStopTimer: 0 NoCurrent: 0 Imeas: 0.0 A IsetBalanced: 16.0 A L1: 8.9 A L2: 34028235080000000000000000000000000000.0 A L3: 34028235080000000000000000000000000000.0 A Isum: 8.9 A
Imeasured:0.0 A IsetBalanced:16.0 A Baseload:0.0 A EVSE0[2]:16.0 A EVSE1[0]:0.0 A EVSE2[0]:0.0 A EVSE3[0]:0.0 A
STATE: C Error: 0 StartCurrent: -4 ImeasuredNegative: 0.0 A ChargeDelay: 0 SolarStopTimer: 0 NoCurrent: 0 Imeas: 0.0 A IsetBalanced: 16.0 A L1: 13.6 A L2: 34028235080000000000000000000000000000.0 A L3: 34028235080000000000000000000000000000.0 A Isum: 13.6 A
Imeasured:0.0 A IsetBalanced:16.0 A Baseload:0.0 A EVSE0[2]:16.0 A EVSE1[0]:0.0 A EVSE2[0]:0.0 A EVSE3[0]:0.0 A
STATE: C Error: 0 StartCurrent: -4 ImeasuredNegative: 0.0 A ChargeDelay: 0 SolarStopTimer: 0 NoCurrent: 0 Imeas: 0.0 A IsetBalanced: 16.0 A L1: 13.4 A L2: 34028235080000000000000000000000000000.0 A L3: 34028235080000000000000000000000000000.0 A Isum: 13.4 A
Imeasured:0.0 A IsetBalanced:16.0 A Baseload:0.0 A EVSE0[2]:16.0 A EVSE1[0]:0.0 A EVSE2[0]:0.0 A EVSE3[0]:0.0 A
STATE: C Error: 0 StartCurrent: -4 ImeasuredNegative: 0.0 A ChargeDelay: 0 SolarStopTimer: 0 NoCurrent: 0 Imeas: 0.0 A IsetBalanced: 16.0 A L1: 14.2 A L2: 34028235080000000000000000000000000000.0 A L3: 34028235080000000000000000000000000000.0 A Isum: 14.2 A
Imeasured:0.0 A IsetBalanced:16.0 A Baseload:0.0 A EVSE0[2]:16.0 A EVSE1[0]:0.0 A EVSE2[0]:0.0 A EVSE3[0]:0.0 A
STATE: C Error: 0 StartCurrent: -4 ImeasuredNegative: 0.0 A ChargeDelay: 0 SolarStopTimer: 0 NoCurrent: 0 Imeas: 0.0 A IsetBalanced: 16.0 A L1: 21.6 A L2: 34028235080000000000000000000000000000.0 A L3: 34028235080000000000000000000000000000.0 A Isum: 21.6 A
Imeasured:0.0 A IsetBalanced:16.0 A Baseload:0.0 A EVSE0[2]:16.0 A EVSE1[0]:0.0 A EVSE2[0]:0.0 A EVSE3[0]:0.0 A
STATE: C Error: 0 StartCurrent: -4 ImeasuredNegative: 0.0 A ChargeDelay: 0 SolarStopTimer: 0 NoCurrent: 0 Imeas: 0.0 A IsetBalanced: 16.0 A L1: 21.7 A L2: 34028235080000000000000000000000000000.0 A L3: 34028235080000000000000000000000000000.0 A Isum: 21.7 A
Imeasured:0.0 A IsetBalanced:16.0 A Baseload:0.0 A EVSE0[2]:16.0 A EVSE1[0]:0.0 A EVSE2[0]:0.0 A EVSE3[0]:0.0 A
STATE: C Error: 0 StartCurrent: -4 ImeasuredNegative: 0.0 A ChargeDelay: 0 SolarStopTimer: 0 NoCurrent: 0 Imeas: 0.0 A IsetBalanced: 16.0 A L1: 21.4 A L2: 34028235080000000000000000000000000000.0 A L3: 34028235080000000000000000000000000000.0 A Isum: 21.4 A
Imeasured:0.0 A IsetBalanced:16.0 A Baseload:0.0 A EVSE0[2]:16.0 A EVSE1[0]:0.0 A EVSE2[0]:0.0 A EVSE3[0]:0.0 A
STATE: C Error: 0 StartCurrent: -4 ImeasuredNegative: 0.0 A ChargeDelay: 0 SolarStopTimer: 0 NoCurrent: 0 Imeas: 0.0 A IsetBalanced: 16.0 A L1: 21.6 A L2: 34028235080000000000000000000000000000.0 A L3: 34028235080000000000000000000000000000.0 A Isum: 21.6 A
Imeasured:0.0 A IsetBalanced:16.0 A Baseload:0.0 A EVSE0[2]:16.0 A EVSE1[0]:0.0 A EVSE2[0]:0.0 A EVSE3[0]:0.0 A
STATE: C Error: 0 StartCurrent: -4 ImeasuredNegative: 0.0 A ChargeDelay: 0 SolarStopTimer: 0 NoCurrent: 0 Imeas: 0.0 A IsetBalanced: 16.0 A L1: 20.7 A L2: 34028235080000000000000000000000000000.0 A L3: 34028235080000000000000000000000000000.0 A Isum: 20.7 A
Imeasured:0.0 A IsetBalanced:16.0 A Baseload:0.0 A EVSE0[2]:16.0 A EVSE1[0]:0.0 A EVSE2[0]:0.0 A EVSE3[0]:0.0 A
STATE: C Error: 0 StartCurrent: -4 ImeasuredNegative: 0.0 A ChargeDelay: 0 SolarStopTimer: 0 NoCurrent: 0 Imeas: 0.0 A IsetBalanced: 16.0 A L1: 20.9 A L2: 34028235080000000000000000000000000000.0 A L3: 34028235080000000000000000000000000000.0 A Isum: 20.9 A
Imeasured:0.0 A IsetBalanced:16.0 A Baseload:0.0 A EVSE0[2]:16.0 A EVSE1[0]:0.0 A EVSE2[0]:0.0 A EVSE3[0]:0.0 A
STATE: C Error: 0 StartCurrent: -4 ImeasuredNegative: 0.0 A ChargeDelay: 0 SolarStopTimer: 0 NoCurrent: 0 Imeas: 0.0 A IsetBalanced: 16.0 A L1: 22.0 A L2: 34028235080000000000000000000000000000.0 A L3: 34028235080000000000000000000000000000.0 A Isum: 22.0 A
Imeasured:0.0 A IsetBalanced:16.0 A Baseload:0.0 A EVSE0[2]:16.0 A EVSE1[0]:0.0 A EVSE2[0]:0.0 A EVSE3[0]:0.0 A
STATE: C Error: 0 StartCurrent: -4 ImeasuredNegative: 0.0 A ChargeDelay: 0 SolarStopTimer: 0 NoCurrent: 0 Imeas: 0.0 A IsetBalanced: 16.0 A L1: 21.5 A L2: 34028235080000000000000000000000000000.0 A L3: 34028235080000000000000000000000000000.0 A Isum: 21.5 A
````

following detaching the P1 and connecting the CT clip:
````
Imeasured:0.0 A IsetBalanced:16.0 A Baseload:0.0 A EVSE0[2]:16.0 A EVSE1[0]:0.0 A EVSE2[0]:0.0 A EVSE3[0]:0.0 A
STATE: C Error: 0 StartCurrent: -4 ImeasuredNegative: 0.0 A ChargeDelay: 0 SolarStopTimer: 0 NoCurrent: 0 Imeas: 0.0 A IsetBalanced: 16.0 A L1: 0.0 A L2: 0.0 A L3: -0.0 A Isum: 0.0 A
Imeasured:0.0 A IsetBalanced:16.0 A Baseload:0.0 A EVSE0[2]:16.0 A EVSE1[0]:0.0 A EVSE2[0]:0.0 A EVSE3[0]:0.0 A
STATE: C Error: 0 StartCurrent: -4 ImeasuredNegative: 0.0 A ChargeDelay: 0 SolarStopTimer: 0 NoCurrent: 0 Imeas: 0.0 A IsetBalanced: 16.0 A L1: -0.0 A L2: -0.0 A L3: 0.0 A Isum: -0.0 A
Imeasured:0.0 A IsetBalanced:16.0 A Baseload:0.0 A EVSE0[2]:16.0 A EVSE1[0]:0.0 A EVSE2[0]:0.0 A EVSE3[0]:0.0 A
STATE: C Error: 0 StartCurrent: -4 ImeasuredNegative: 0.0 A ChargeDelay: 0 SolarStopTimer: 0 NoCurrent: 0 Imeas: 0.0 A IsetBalanced: 16.0 A L1: -0.0 A L2: 0.0 A L3: -0.0 A Isum: -0.0 A
Imeasured:0.0 A IsetBalanced:16.0 A Baseload:0.0 A EVSE0[2]:16.0 A EVSE1[0]:0.0 A EVSE2[0]:0.0 A EVSE3[0]:0.0 A
STATE: C Error: 0 StartCurrent: -4 ImeasuredNegative: 0.0 A ChargeDelay: 0 SolarStopTimer: 0 NoCurrent: 0 Imeas: 0.0 A IsetBalanced: 16.0 A L1: 0.0 A L2: 0.0 A L3: 0.0 A Isum: 0.0 A
Imeasured:0.0 A IsetBalanced:16.0 A Baseload:0.0 A EVSE0[2]:16.0 A EVSE1[0]:0.0 A EVSE2[0]:0.0 A EVSE3[0]:0.0 A
STATE: C Error: 0 StartCurrent: -4 ImeasuredNegative: 0.0 A ChargeDelay: 0 SolarStopTimer: 0 NoCurrent: 0 Imeas: 0.0 A IsetBalanced: 16.0 A L1: 0.0 A L2: -0.0 A L3: -0.0 A Isum: 0.0 A
Imeasured:0.0 A IsetBalanced:16.0 A Baseload:0.0 A EVSE0[2]:16.0 A EVSE1[0]:0.0 A EVSE2[0]:0.0 A EVSE3[0]:0.0 A
STATE: C Error: 0 StartCurrent: -4 ImeasuredNegative: 0.0 A ChargeDelay: 0 SolarStopTimer: 0 NoCurrent: 0 Imeas: 0.0 A IsetBalanced: 16.0 A L1: -0.0 A L2: -0.0 A L3: 0.0 A Isum: 0.0 A
Imeasured:21.0 A IsetBalanced:15.0 A Baseload:0.0 A EVSE0[2]:15.0 A EVSE1[0]:0.0 A EVSE2[0]:0.0 A EVSE3[0]:0.0 A
STATE: C Error: 0 StartCurrent: -4 ImeasuredNegative: 0.0 A ChargeDelay: 0 SolarStopTimer: 0 NoCurrent: 0 Imeas: 21.0 A IsetBalanced: 15.0 A L1: 21.1 A L2: 0.0 A L3: 0.0 A Isum: 21.1 A
Imeasured:18.9 A IsetBalanced:15.2 A Baseload:0.0 A EVSE0[2]:15.2 A EVSE1[0]:0.0 A EVSE2[0]:0.0 A EVSE3[0]:0.0 A
STATE: C Error: 0 StartCurrent: -4 ImeasuredNegative: 0.0 A ChargeDelay: 0 SolarStopTimer: 0 NoCurrent: 0 Imeas: 18.9 A IsetBalanced: 15.2 A L1: 19.0 A L2: -0.0 A L3: -0.0 A Isum: 19.0 A
Imeasured:18.6 A IsetBalanced:15.5 A Baseload:0.0 A EVSE0[2]:15.5 A EVSE1[0]:0.0 A EVSE2[0]:0.0 A EVSE3[0]:0.0 A
STATE: C Error: 0 StartCurrent: -4 ImeasuredNegative: 0.0 A ChargeDelay: 0 SolarStopTimer: 0 NoCurrent: 0 Imeas: 18.6 A IsetBalanced: 15.5 A L1: 18.6 A L2: 0.0 A L3: 0.0 A Isum: 18.6 A
Imeasured:18.4 A IsetBalanced:15.9 A Baseload:0.0 A EVSE0[2]:15.9 A EVSE1[0]:0.0 A EVSE2[0]:0.0 A EVSE3[0]:0.0 A
STATE: C Error: 0 StartCurrent: -4 ImeasuredNegative: 0.0 A ChargeDelay: 0 SolarStopTimer: 0 NoCurrent: 0 Imeas: 18.4 A IsetBalanced: 15.9 A L1: 18.4 A L2: 0.0 A L3: -0.0 A Isum: 18.4 A
Imeasured:20.0 A IsetBalanced:15.9 A Baseload:0.0 A EVSE0[2]:15.9 A EVSE1[0]:0.0 A EVSE2[0]:0.0 A EVSE3[0]:0.0 A
STATE: C Error: 0 StartCurrent: -4 ImeasuredNegative: 0.0 A ChargeDelay: 0 SolarStopTimer: 0 NoCurrent: 0 Imeas: 20.0 A IsetBalanced: 15.9 A L1: 20.1 A L2: 0.0 A L3: -0.0 A Isum: 20.1 A
Imeasured:20.8 A IsetBalanced:15.1 A Baseload:0.0 A EVSE0[2]:15.1 A EVSE1[0]:0.0 A EVSE2[0]:0.0 A EVSE3[0]:0.0 A
STATE: C Error: 0 StartCurrent: -4 ImeasuredNegative: 0.0 A ChargeDelay: 0 SolarStopTimer: 0 NoCurrent: 0 Imeas: 20.8 A IsetBalanced: 15.1 A L1: 20.8 A L2: 0.0 A L3: -0.0 A Isum: 20.8 A
Imeasured:20.9 A IsetBalanced:14.2 A Baseload:0.0 A EVSE0[2]:14.2 A EVSE1[0]:0.0 A EVSE2[0]:0.0 A EVSE3[0]:0.0 A
STATE: C Error: 0 StartCurrent: -4 ImeasuredNegative: 0.0 A ChargeDelay: 0 SolarStopTimer: 0 NoCurrent: 0 Imeas: 20.9 A IsetBalanced: 14.2 A L1: 21.0 A L2: -0.0 A L3: -0.0 A Isum: 21.0 A
Imeasured:20.5 A IsetBalanced:13.7 A Baseload:0.0 A EVSE0[2]:13.7 A EVSE1[0]:0.0 A EVSE2[0]:0.0 A EVSE3[0]:0.0 A
STATE: C Error: 0 StartCurrent: -4 ImeasuredNegative: 0.0 A ChargeDelay: 0 SolarStopTimer: 0 NoCurrent: 0 Imeas: 20.5 A IsetBalanced: 13.7 A L1: 20.6 A L2: -0.0 A L3: 0.0 A Isum: 20.6 A
Imeasured:19.9 A IsetBalanced:13.7 A Baseload:0.0 A EVSE0[2]:13.7 A EVSE1[0]:0.0 A EVSE2[0]:0.0 A EVSE3[0]:0.0 A
STATE: C Error: 0 StartCurrent: -4 ImeasuredNegative: 0.0 A ChargeDelay: 0 SolarStopTimer: 0 NoCurrent: 0 Imeas: 19.9 A IsetBalanced: 13.7 A L1: 19.9 A L2: 0.0 A L3: -0.0 A Isum: 19.9 A
Imeasured:19.4 A IsetBalanced:13.8 A Baseload:0.0 A EVSE0[2]:13.8 A EVSE1[0]:0.0 A EVSE2[0]:0.0 A EVSE3[0]:0.0 A
STATE: C Error: 0 StartCurrent: -4 ImeasuredNegative: 0.0 A ChargeDelay: 0 SolarStopTimer: 0 NoCurrent: 0 Imeas: 19.4 A IsetBalanced: 13.8 A L1: 19.4 A L2: 0.0 A L3: 0.0 A Isum: 19.4 A
Imeasured:19.4 A IsetBalanced:13.9 A Baseload:0.0 A EVSE0[2]:13.9 A EVSE1[0]:0.0 A EVSE2[0]:0.0 A EVSE3[0]:0.0 A
STATE: C Error: 0 StartCurrent: -4 ImeasuredNegative: 0.0 A ChargeDelay: 0 SolarStopTimer: 0 NoCurrent: 0 Imeas: 19.4 A IsetBalanced: 13.9 A L1: 19.5 A L2: -0.0 A L3: -0.0 A Isum: 19.5 A
Imeasured:19.1 A IsetBalanced:14.1 A Baseload:0.0 A EVSE0[2]:14.1 A EVSE1[0]:0.0 A EVSE2[0]:0.0 A EVSE3[0]:0.0 A
STATE: C Error: 0 StartCurrent: -4 ImeasuredNegative: 0.0 A ChargeDelay: 0 SolarStopTimer: 0 NoCurrent: 0 Imeas: 19.1 A IsetBalanced: 14.1 A L1: 19.1 A L2: -0.0 A L3: 0.0 A Isum: 19.1 A
Imeasured:18.9 A IsetBalanced:14.3 A Baseload:0.0 A EVSE0[2]:14.3 A EVSE1[0]:0.0 A EVSE2[0]:0.0 A EVSE3[0]:0.0 A
STATE: C Error: 0 StartCurrent: -4 ImeasuredNegative: 0.0 A ChargeDelay: 0 SolarStopTimer: 0 NoCurrent: 0 Imeas: 18.9 A IsetBalanced: 14.3 A L1: 19.0 A L2: -0.0 A L3: 0.0 A Isum: 19.0 A
Imeasured:19.0 A IsetBalanced:14.5 A Baseload:0.0 A EVSE0[2]:14.5 A EVSE1[0]:0.0 A EVSE2[0]:0.0 A EVSE3[0]:0.0 A
STATE: C Error: 0 StartCurrent: -4 ImeasuredNegative: 0.0 A ChargeDelay: 0 SolarStopTimer: 0 NoCurrent: 0 Imeas: 19.0 A IsetBalanced: 14.5 A L1: 19.1 A L2: -0.0 A L3: 0.0 A Isum: 19.1 A
````

it looks like that something goes wrong with the data from the smart meter because I am not using a 3 phase connection (yet).
I'm not that great with microcontroller code so I did not further investigate if the problem lies within the decoding of the modbus data or that the sensorbox is not sending the correct data.

but I think that the load-balancing breaks on the fact that the values are so high that it cannot be put into the Imeasuered signed int. (or at least the seem incompatible)
but since the numbers are higher then the previous values it does try to overwrite them.

It might be a good idea to do a sanity check on the data that is coming in, as it is quite dangerous that the car keeps charging while it does not know the correct current.

please let me know if you want me to debug anything on the smartevse or P1 port!
(i not too confident with embedded C programming (especially when it comes to pointers))

mstegen, 2020-06-15:
This was caused by the sensorbox expecting three phase data from the smartmeter. This is now fixed. As it will check if the data is available, and if it's valid.

Closed 2020-06-27.

Thread 24 (2020-06-14):

PV adjusted current by using Sensor Box

mcarcog, 2020-06-14:
Hi, is there already the possibility to use the Sensor box to detect the output AC power of a PV System?

So the sensors box should increase the current and not reduce.

Thanks for replying

mstegen, 2020-06-15:
The SmartEVSE expects the Sensorbox to be at the point where the electricity is feed into the house. At this location it can determine if the current is flowing to the grid, or if power is drawn from the grid. Therefore it doesn't need a separate sensorbox which only monitors the power generated by the PV system.
Btw you need the Sensorbox 2 for this to work, as the Sensorbox 1 (and 1.5) can not determine the direction of the current.

With this in place, it will try to charge the car only with solar power(in Solar mode). It does this by monitoring the measured currents, and trying to adjust the charger of the EV so that the sum of all currents is zero.

mcarcog, 2020-06-15:
Thanks much for your answer. Nice to hear, that this feature is already implemented.

Closed 2020-06-15.

Thread 25 (2020-06-22):

Control charging current directly via Modbus

heisly, 2020-06-22:
Hello,
I like the Smart EVSE very much because of its pretty design including the display and it is a economic setup together with the RCM14, very good job!
I would like to integrate Smart EVSE within my Loxone Miniserver via existing Modbus Gateway with some existing SDM630 power meters.
Therefore I would like the visualize the actual state (ready, vehicle connected, charging) in the Loxone App (I think this is already possible) and **control the charging current directly via modbus** (as I already have all the power and energy information and the necessary logic in loxone).

Is that already possible (maybe I haven’t seen it) or something interesting to integrate in the future?
Maybe it is possible to simply allow an override of the charging current in the Solar Mode.
I would highly appreciate that!

Otherwise: I like the Smart EVSE anyway 😉.

Greetings, Stephan

bobosch, 2020-06-22:
Hi,
yes, SmartEVSE can use the SDM630 and you can use modbus to get some information
https://github.com/SmartEVSE/smartevse#modbus-registers
But currently you have to update the configuration to set the charging current (would be saved every time :-( )
I like the idea of overriding the charging current, but it would be only possible in normal mode. In Smart and Solar mode the charging current is updated periodically...
Regards, Robert

heisly, 2020-06-23:
Override the Charging Current in Normal Mode would also be fine. But to make sure, with the actual firmware this is not possible, right?

bobosch, 2020-06-24:
Yes, only the commands listed on https://github.com/SmartEVSE/smartevse#modbus-registers (since Version 2.10)

Fnikan, 2020-06-25:
Hi,
I have the same problem. Actually i want to send START/STOP command with modbus to SmartEvse and control the charging current too. I am thinking about adding a new register for that and modifing the code for that( The part of IO2 which is for START/STOP). But until now no idea how to add a new register to SmartEvse.
Btw thanks for this big work!

bobosch, 2020-06-25:
START/STOP charging is already possible by setting the access bit register 0xA7

bobosch, 2020-06-25:
I'll make the modbus charging current register 0xA6 writeable

heisly, 2020-06-26:
Hey bobosch, that sounds really great, thanks for that!
BTW, the modbus Interface is working with a fixed Baudrate of 9600 Baud and a fixed Address, right? So I need to make some changes on my already existing meters to have them all on the same Modbus and bring them together with Smart EVSE within one gateway to the Modbus TCP.

bobosch, 2020-06-27:
Solved with commit 759f2c0051b062f5aac2e70332bb3b9dd5c9b2dc
Works also in Smart Mode. Don't forget to set value to 0 to let SmartEVSE control the current.
[SmartEVSE2.X.production.zip](https://github.com/SmartEVSE/smartevse/files/4840118/SmartEVSE2.X.production.zip)

bobosch, 2020-06-27:
BTW: Yes, RS485 settings and the address are hardcoded.

heisly, 2020-06-28:
That's fine, I also seen it in the EVSE.c I'm already on the same Baudrate and just have to change the address of one of my meters to reserve 1 for the Smart EVSE.

Closed 2020-06-27.

Thread 26 (2020-07-15):

Charging not working - red light on the car

bostjanlaba, 2020-07-15:
Having setup SmartEvse with fixed cable, 3 phase with RC Mon, no smart mode, no switch, 16A.

Display says READY TO CHARGE. Plugging the cable into car shows red light on the car. SmartEvse reports nothing, but does not charge.
Only thing discovered is that for some reason pins PP and CP on the smartevse itself (without any cables attached) are shorted.

What could be the reason?

mstegen, 2020-07-15:
Make sure that you do not connect the PP wire to the charging cable. Only the CP wire (and PE) should be connected from the fixed charging cable to the SmartEVSE.
The PP connection should only be connected if a charging socket is used.

When the SmartEVSE detects a connected car, the back light of the screen will light up. It will still show "READY TO CHARGE" though. Only if the car asks for power, the contactor will close, and "CHARGING" will be displayed.

bostjanlaba, 2020-07-15:
Hi,

I have tried disconnecting PP from smartevse (though in the plug, there is still resistor between PP and PE). But the result was the same. Should I remove the pin from the plug all together?

Does having shortage between PP and CP on smartevse is ok?

Thanks for you super quick reply!

⁣Lep dan/Best Regards

Boštjan Laba

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

bostjanlaba, 2020-07-15:
Hi again,

just want to say it was a faulty cable (PP had 500 ohm instead of 680ohm)

All good now, thanks!

⁣Lep dan/Best Regards

Boštjan Laba

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

mstegen, 2020-07-15:
Ah, ok thanks for letting me know.

bostjanlaba, 2020-07-15:
Hi again. Now generally chargin is working but not for long. Could be 1 hr or less but then a car reports no electricity available.

All fuses are ok, no error on the smartevse, instead of charging now it says ready to charge. Taking plug out and back into vehicle does nothing, not even initial communication is seen on the car. If i turn smartevse off and back on, station will operate normally for another short period of time as expected.

Any idea what is this? Thanks.

⁣Lep dan/Best Regards

Boštjan Laba

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

Closed 2020-07-15.

Thread 27 (2020-07-19):

Config shielded with PIN

laemen, 2020-07-19:
Feature request: I have the SmartEVSE semi-outside (garage), and protected with a Raspberry Pi with RFID meter switching the SmartEVSE switch pin.
However you can easily go info the configuration and disable the switch pin, enabling the SmartEVSE and the actuator. Shielding this with a 4 digit pin would prevent that. The SDM630 has PIN shielding for comparison.

mstegen, 2020-07-26:
Sure i can add that in a future version. But how to reset the pin in case you forget it somehow?

- Allow a PIN reset by holding a button on the front when powering on?
- Only allow PIN reset by reprogramming the controller with the FTDI cable.
- Any other idea?

laemen, 2020-07-26:
PIN reset through a button on the front would void the protection. A physical recovery would be the best, reprogramming through the FTDI would have my vote.
Couldn't find how the SDM630 recovers the PIN, maybe by buying a new one 😳

Links2004, 2020-09-20:
may this helps as base:
https://github.com/SmartEVSE/smartevse/pull/33/commits/aed6ccbbc5874c5bd411822326e6e05316b8c092

I Impediment a simple lock that can be enabled and disabled via Modbus

## Register 0xD*: Extended Configuration

Register | Access | Description | Unit | Values
--- | --- | --- | --- | ---
0xD0 | R/W | Disable Menu | | 0: Menu Enabled  / 1: Menu Disable

PR open:
https://github.com/SmartEVSE/smartevse/pull/33

bobosch, 2020-12-02:
> PIN reset through a button on the front would void the protection.

... "holding a button on the front **when powering on**" If you are able to switch the power on and off you have physical access ... IMHO the best solution.
@Links2004 yes, it should be also accessable via modbus. I will merge this commit

Thread 28 (2020-07-20):

Charging stops for no "apparent reason"

bostjanlaba, 2020-07-20:
Charging a car normally at 10,5kW for 2-3 hrs. Suddently charging stops. No error. Contactor is disconnected (off).

Car reports that there is sudden loss in current. SmartEVSE shows Ready to charge. Disconnecting the cable and reconnecting it to the car makes no change. No communication with the car at all.

Shutting down SmartEvse and restarting normally continues the charge.

So for some reason it looks like mains get disconnected on contactor and station goes into Ready to Charge and "freezes" there...

RC Monitor can be enabled or disabled, no difference.

Any idea why?

Bostjan

mstegen, 2020-07-26:
Could it be that the SmartEVSE get's too hot? It will stop charging when the temperature sensor measures 65 C.
It will continue charging again if the temperature drops below 55 C.
I just checked and the current version does not show the ERROR HIGH TEMP message, just READY TO CHARGE when it get's too hot.
I'll fix this bug in the next version.

You can monitor the temperature by connecting a FTDI cable to to SmartEVSE, and using a terminal program like putty to connect to it. Pressing enter should bring up the CLI menu

    ----------------------------- SMART EVSE -----------------------------
     v2.17 for detailed instructions, see www.smartevse.org
     Internal Temperature: 29 C
    ----------------------------------------------------------------------
    CONFIG  - Set to Fixed Cable or Type 2 Socket                - Socket
    LOCK    - Cable locking actuator type                        - Disabled
    MODE    - Set to Normal, Smart or Solar EVSE mode            - Normal
    LOADBL  - Set Load Balancing mode for 2-4 SmartEVSEs         - Disabled
    MAX     - Set MAX Charge Current for this EVSE               - 13 A
    SW      - Switch function control on pin SW                  - Disabled
    RCMON   - Residual Current Monitor on pin RCM                - Disabled
    >

bostjanlaba, 2020-07-26:
Hi

Yes, this would be quite possible. The ev charging box is outside and there is a lot of sun. Does evse get hot because of the charging or only because of hot environment?

Not surw how to cool it down though...

⁣Lep dan/Best Regards

Boštjan Laba

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

mstegen, 2020-07-26:
Hi,
If the SmartEVSE controller is next to the contactor, and this get's hot, maybe you can create a air gap between the two? (maybe rearrange them on the DIN rail?)
The controller doesn't get hot by itself, so it must be from outside sources..
-Michael

bostjanlaba, 2020-07-26:
Hi,

SmartEvse is between RCCB and MCBs. Contactor is one line lower but indeed just beneath SmartEvse.

I will try and move them further apart. I’d put in a vent but since it’s an outside box it has to be water and dust resistant :/

Will report back on findings.

Bostjan

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

stefan345, 2020-07-31:
@bostjanlaba I have the same issue. Out of curiosity: which car are you trying to charge?

bostjanlaba, 2020-07-31:
Hi, audi etron. Everywhere else I charge I have zero problems.

Tomorrow I am removing classic rccb and mcbs and replacing them with combo which will give me some room to have smartevse almost alone on the din rail. Hopefully it will help...

⁣Lep dan/Best Regards

Boštjan Laba

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

bostjanlaba, 2022-08-08:
To whom it may concern. It's a problem with overheating. Issues are only during summer, particularly if sun is shining directly on the box. So either we cool it actively or move it into permanent shadows. We'll see.

mstegen, 2022-08-09:
I've seen custom enclosures with a mesh at the backside of the enclosure (top and bottom), shielded from rain, but it allows airflow through the box.

Closed 2022-08-08.

Thread 31 (2020-08-20):

How to do with solar energy?

LolDeibid, 2020-08-20:
Hi all,

First i have to thanks to all of the developers. After 1 year of use i couldn't be happier.

Now a friend just get a Leaf and he has solar power energy at home. My software version is an old one and i know that the latest version allows to setup with solar, but... how it works? I can't find where to connect the sensor box or if i need to do something special, i just know that i can select "solar mode" =/

Can you please help me??

Regards!!

mstegen, 2020-08-24:
The Sensorbox 1 or 1.5 can only measure the current, not the direction of the current flow.

Sensorbox 2 can do this, as it has a separate voltage input, to determine the direction of the current. (phase difference)
It needs to be connected to the same main phase wire, as with the sensorbox 1.

So the current sensor (CT) doesn't need to change, just plug it in the sensorbox 2.

-Michael

Thread 34 (2020-10-08):

Empty if statement for PWM cycle > 92% detection

arjanmels, 2020-10-08:
The if in the first line line has a semicolon after the if, so the codeblock following will always be executed. Is this the intention?

https://github.com/SmartEVSE/smartevse/blob/fc20d524fc929fd35ff26eb7a4711927521eb577/version2/SmartEVSE2.X/EVSE.c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

mstegen, 2020-10-09:
Good Catch!

No this is not intended. I'll fix it in the next release.
Thanks.

arjanmels, 2020-10-09:
I caught it because I switched my fork to c99 compiler which gives a warning for this.

c99 compiler (clang) has much nicer error messages. However if I use the c99 lib instead of the c90 lib the size grows from ~77% to 85% of memory. It is possible to use c99 language mode with c90 library (you get some warnings in doprint.c, btu it does compile).

bobosch, 2020-11-25:
Commited d5128d51e0da15336191b8412c4f42dfb078b48f

Closed 2020-11-25.

Thread 35 (2020-10-16):

load balancing algoritme

BitterAndReal, 2020-10-16:
How is the load balancing between multiple EVSE's done at the moment if they do not measure the current each car is drawing?
Is the total available current equally shared by the EVSE's with a car connected or is there a smart algoritme which checks if a car actually uses his share of the current?
So one car could charge with 90% of the available current and the other with 10% for example.

mstegen, 2020-10-18:
It can only determine if the car is charging or not, it will therefore for multiple EVSE's just share the max chargecurrent between the EVSE's that have a car connected and are charging. If one of the EV's is finished charging it will recalculate this value.

The max chargecurrent is in Smart mode also determined by what's measured on the MAINS connection. If it's not exceeding the set value it will increase the chargecurrent. If it detects a higer current on one of the phases then what is set in the controller (MAINS) then it will decrease the chargecurrent.

BitterAndReal, 2020-10-19:
Thanks for the explanation. Really smart solution!
Does that mean I could have two EVSE's sharing a 25A mains connection both allowing the connected car to charge with 20A but one car is only drawing 5A for example?

mstegen, 2020-10-20:
With two cars charging, both cars will get 12.5A If one EV is only drawing 5A, the other one will still only charge with max 12.5A
until the first one is full, and stops charging, then the other one will get the full 25A.

Closed 2020-11-17.

Thread 38 (2020-11-16):

solar mode - start current immediately

Tom9731, 2020-11-16:
Hello, is it possible to set a basic charge current of 6A in 'solar' mode and it will start charging immediately with the 6A (without any pv current).
If the PV supplies more current, it will increase the charge current.

Thx

Regards Tom

mstegen, 2020-11-17:
At the moment this is not possible. It will wait for minimum 1A (START current) solar power on one of the phases before it starts charging (at 6A).

A workaround is to start charging in Smart mode, and then switch to Solar mode. Then it will keep charging at 6A, until the STOP timer runs out. You can set the STOP timer to Disabled, to keep charging at a minimum of 6A.
If your PV supplies more current it will then increase the charge current.

If you connect a (pushbutton) switch to the SW input of the SmartEVSE you can easily switch between Smart/Solar charging by pressing the button.

I hope this helps.

-Michael

Closed 2021-02-12.

Thread 41 (2020-12-13):

Add start/stop charging register to modbus implementation

neographikal, 2020-12-13:
I would like to start/stop charging through modbus. As I see it now, I can set the charging current, but cannot start/stop by a call over modbus.

bobosch, 2020-12-13:
You could use the access bit 0xA7

neographikal, 2020-12-17:
This is working, maybe somewhat cleaner than using the modes, but still not really a clean start/stop method. Dedicated functions for this would be nice.

Thread 43 (2020-12-17):

Modbus Register 0x0* broadcast: strange implementation

neographikal, 2020-12-17:
I tried to use these functions from standard modbus libraries (Python, Arduino) but these functions are weirdly structured. Some devices do use 32bit registers, but these are quite rare. Using function code 16 to write 4 values in standard libraries result in

0x01
0x02
0x03
0x04

being written instead of 4 values at one address. This does not seem to conform to the Modbus standard. Secondly, why use broadcasting at all, why not let the master address the 4 slaves individually by writing one register with the standard write register function. This way you also have confirmation that the slave recognized the request and acts accordingly.

The docs are also quite limited on how these function should be called, just calling it does remove the communications error on the smartevse, but it seems to stall: buttons do not work any more.

bobosch, 2020-12-17:
On this modbus implementation registers are 16bit "words". I don't understand your example, as there are only 2 words. Please write down the complete code with the request statement, the data you receive and the data you expect to receive

neographikal, 2020-12-17:
Minimal-modbus python example:

```
#!/usr/bin/env python3
import minimalmodbus
import serial
import time

instrument = minimalmodbus.Instrument('COM4', 0, debug=True)  # port name, slave address (in decimal)
instrument.mode = minimalmodbus.MODE_RTU
instrument.serial.baudrate = 9600         # Baud
instrument.serial.bytesize = 8
instrument.serial.parity   = serial.PARITY_NONE
instrument.serial.stopbits = 1
instrument.address = 0

while True:
    try:
        instrument.write_registers(0x01, [8, 8, 8, 8])
    except:
        print("Error")
    time.sleep(2)
```

This would try to write 4 consecutive registers starting from 0x01 as per the modbus spec: https://www.simplymodbus.ca/FC16.htm. The implementation calls for function code 16, writing multiple registers while writing only one register with 4 values for 4 devices. This seems quite strange to me.

bobosch, 2020-12-18:
The behavior is defined in the program, not in the library. The program has to decide which register is valid and which not. Yes, register 0x0* are implemented in a proprietary way. I will change the documentation, these registers are not meant to used from external.

Please try the register 0xA0 and higher.

neographikal, 2020-12-18:
Will do, still, if you are doing in a proprietary, why not use the correct function code: write single register. In effect you are writing 32bits to 1 register, uncommon but not against spec (there are more devices doing that).

bobosch, 2021-01-24:
Partially done with commit ad18506c522805bdc812d8aac3ab90fc26d51130
But we decided to use another address as broadcast address to avoid unexpected behavior of some modbus devices.
I will also clean up the current broadcast in the future.

Closed 2021-01-24.

Thread 45 (2022-02-28):

Strange behaviour

rvdgaag, 2022-02-28:
Smart-evse V2 with 2.3 firmware

When set to smart mode, with both a SDM-630 for the EV and Mains, the charger starts and after a couple of seconds it closes the contactor again, starts again over and over. There are no other heavy users in the home grid active so the full 3x25A is available.

With normal charging everything works fine.

Any ideas ?

mstegen, 2022-02-28:
Did you set two different modbus addresses for each SDM630?

rvdgaag, 2022-02-28:
Yes I did, no 1 is the evse, 11 is the sdm630 for the EV and 12 is for the mains including PV.
________________________________
Van: Michael Stegen ***@***.***>
Verzonden: Monday, February 28, 2022 10:36:16 AM
Aan: SmartEVSE/smartevse ***@***.***>
CC: rvdgaag ***@***.***>; Author ***@***.***>
Onderwerp: Re: [SmartEVSE/smartevse] Strange behaviour (Issue #45)

Did you set two different modbus addresses for each SDM630?

—
Reply to this email directly, view it on GitHub<https://github.com/SmartEVSE/smartevse/issues/45#issuecomment-1054064624>, or unsubscribe<https://github.com/notifications/unsubscribe-auth/ACNTC37ILHK62ZKRYTDWT33U5M6ZBANCNFSM5PQIXMXQ>.
Triage notifications on the go with GitHub Mobile for iOS<https://apps.apple.com/app/apple-store/id1477376905?ct=notification-email&mt=8&pt=524675> or Android<https://play.google.com/store/apps/details?id=com.github.android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>.
You are receiving this because you authored the thread.Message ID: ***@***.***>

mstegen, 2022-02-28:
address 11 and 12 should be ok.
The measured (Mains) currents for each phase should be visible on the LCD of the SmartEVSE. Also when the EV is not charging.
Do these currents look OK?

rvdgaag, 2022-02-28:
Yes it is fine, it worked fine for a couple of months but now it is a disaster.

Also reading the MODBUS registers with an external Iobroker gateway works fine.

rvdgaag, 2022-02-28:
In the mean time I found that when I disconnect the iobroker gateway (which polls data every 10seconds), the Smart EVSE works as it should. To me it looks like the Smart EVSE misses data from the mains meter by collisions ?? And shuts off.

Any suggestions how to solve this ? I bought the ease mainly because I could monitor it via modbus.

bobosch, 2022-02-28:
SmartEVSE interrupts measurement when detecting another modbus master
https://github.com/SmartEVSE/SmartEVSE-2/commit/1f0bc9ffe44c02f13dfd7752a36b76c7062dc0f0
10seconds is quite often, maybe try 30 or more seconds

rvdgaag, 2022-03-04:
Ok topic can be closed, the to frequent data requests caused collisions so the smart else did not receive the data from the SDM-630 and cut off the power.

Thanks for the support

Closed 2024-07-11.

Thread 46 (2022-04-16):

Can't get the thing charging :)

Hansi3, 2022-04-16:
Hi, I'm new here and trying to charge my car on solar power with Smart EVSE.
I wired a cabinet with a 4 pole switch, kwh meter, contactor and EVSE controller according to the schedule provided. The thing is wired to an external socket with locking pin (±10m cable trajectory). I also added a LED pushbutton.

Anyhow, I think I configured the menu in a sensible way and the display tells me 'ready to charge'.
When I plug in a cable there happens exactly nothing. No error, no charging, no socket locking whatsoever.
I already removed the push button cabling to extract a fault possibility.

Anyone any suggestion on how to debug this? Thanks a lot. Hans from NL

mstegen, 2022-04-16:
A distance of 10 meters from SmartEVSE to socket is on the long side.. especially if you then connect another 5 meters of charging cable. The SmartEVSE was designed to be close to the socket. The sensorbox on the other hand, can be far away, as it is connected with a RS485 connection. distances >100m are no problem.

But in order to troubleshoot this, you can try to measure 12V between the CP and PE/ground connection on the charging socket. There should be no car connected.
If there is no 12V present, the ground connection is most likely not connected to the SmartEVSE's  PE terminal.

I hope this helps.
-Michael Stegen

Hansi3, 2022-04-16:
I measured .021V over CP/PE on both the socket and the controller. Surprisingly before powering on the whole thing I measured .110V on the same position.

Hansi3, 2022-04-16:
I will check the PE wiring in a while

Hansi3, 2022-04-23:
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

Hi Michael,
My last reply wasn't correct. In a hurry I had my multimeter on AC (stupid..). There is a DC voltage of 11.8V over the CP/PE. I checked the wiring and can't find a fault. Do I have any alternative besides dismantling the entire setup and replacing it with a setup with controller and socket in one cabinet? Thanks, Hans

mstegen, 2022-04-23:
Some other things to check. You mentioned you are using a charging socket with locking pin.

Maybe obvious, but i have seen it before:
- make sure the locking pin is not preventing you from plugging in the charging cable all the way into the socket.
- plug in the charging cable into the socket, and measure the CP/PE again on the charging plug that normally would plug into the EV.
- if you do not measure 12V here, the charging socket is most likely mounted on a thick plate, which prevents you from fully inserting the cable into the socket.

I hope this helps.

Hansi3, 2022-04-23:
>
Altough obvious I never thought of it Michael. You're help is appreciated a lot. There's no voltage on the plugged in cable, most likely since there's a substantial panel thickness. I'll take it apart and test with the socket removed from the panel. I'll post an update. I really appreciate your swift helpful posts. Regards, Hans

Hansi3, 2022-04-25:
Done! It works. Turns out the problem was in the locking solenoid that was wired reversed.

mstegen, 2022-04-25:
I'm glad you figured out the problem, and it's fixed now!

Closed 2022-04-25.

Thread 48 (2024-12-10):

Smart EVSE shows "Out of Order" with Red light on push button.

bjolyon, 2024-12-10:
Fully functional Smart EVSE running in Solar Mode with Modbus inout from smart meter suddenly (when not charging and not connected to car) showed "Out Of Order". Disconnecting and reconnecting to mains continues to show "Out of Order". What circumstances can lead to this message?

mstegen, 2024-12-10:
Out of order is a message used by OCPP.
If it has not yet established a connection with the backend server, it will show this message.

Thread 49 (2025-01-22):

Ford Kuga shows charging error

evertvanes, 2025-01-22:
(I seem to have posted this in the wrong project... should be smartevse3)

I have two vehicles that I regularly connect to my smartevse v3 charger using the latest software. A BMW works very well with smartevse, I have not had any issues. But our Ford Kuga does not like the way the smartevse works.

With some persuation I can charge the Ford Kuga but almost all sessions end up in error. And connecting the Kuga to the cable must be done in a certain order or the charge will not start. If I connect the cable before the smartevse is active the Ford will error and only continue by disconnecting the cable first, then enable smartevse and connect. Only then the charge will start. As soon as I disable the smartevse while it is connected the Ford will error.

In order to diagnose the Ford issues I have a raspberry pi which uses telnet to log all smartevse messages to syslog. If any one needs this functionality just install screen and start a new session. In this session start the command:
telnet 192.168.1.10 | logger -t smartevse
now put the session in the background, you can then look at syslog file while messages are collected.

My setup uses a separate p1 monitor and the API is used to send the L1/2/3 values to the smartevse. And I have a fixed cable outside my house, I use a switch to disable or enable the smartevse

When I look at all the messages, I found that last night at 03:48 there was a State change from B to B1 because the API had a timeout, for 30 seconds there was no P1 information. The state change to B1 also disconnects the contactor, even when the car is not charging. I think the Ford Kuga does not like the power being disconnected.

Any thoughts on what to do to further diagnose and maybe solve the situation?

Anyone with experience on charging Ford Hybrid vehicles?

Any help appreciated. Very happy with the hardware and software!

Closed 2025-01-22.
