SmartEVSE/smartevse/eagle/SmartEVSE.pdf

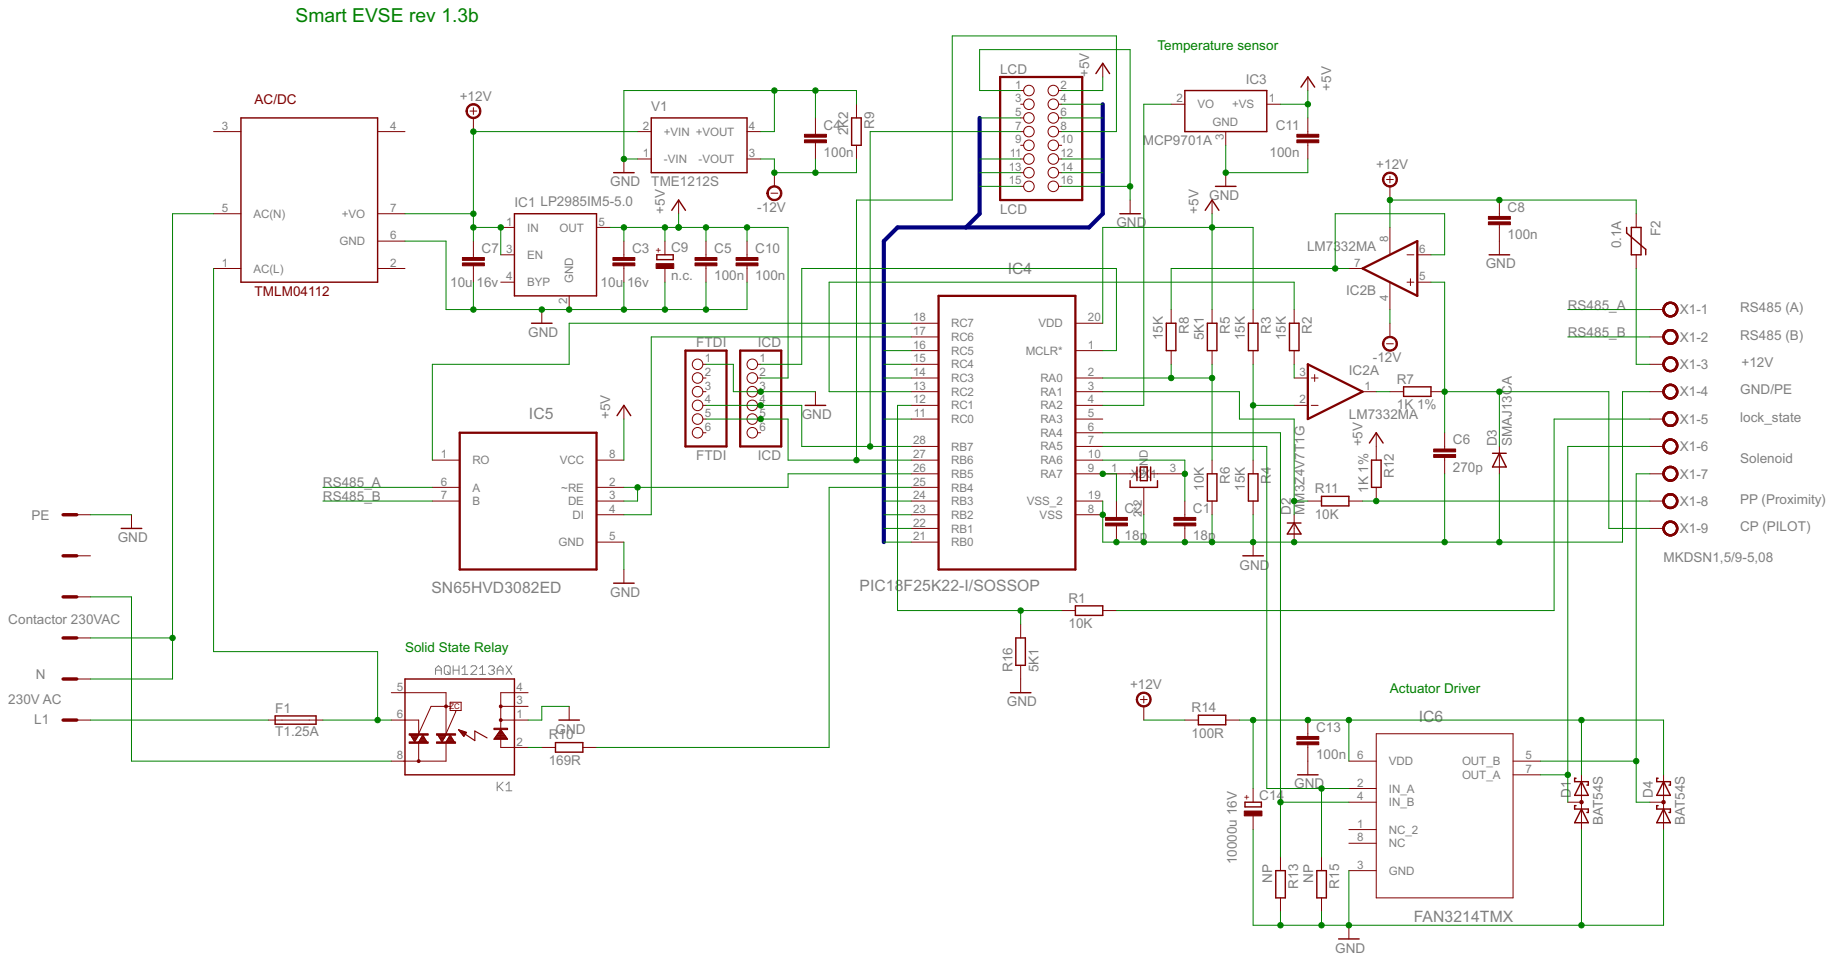
[picture p30: page 1]

CP (PILOT) PP (Proximity)

Actuator Driver Solid State Relay
