SmartEVSE/smartevse/eagle/LCD_board.pdf

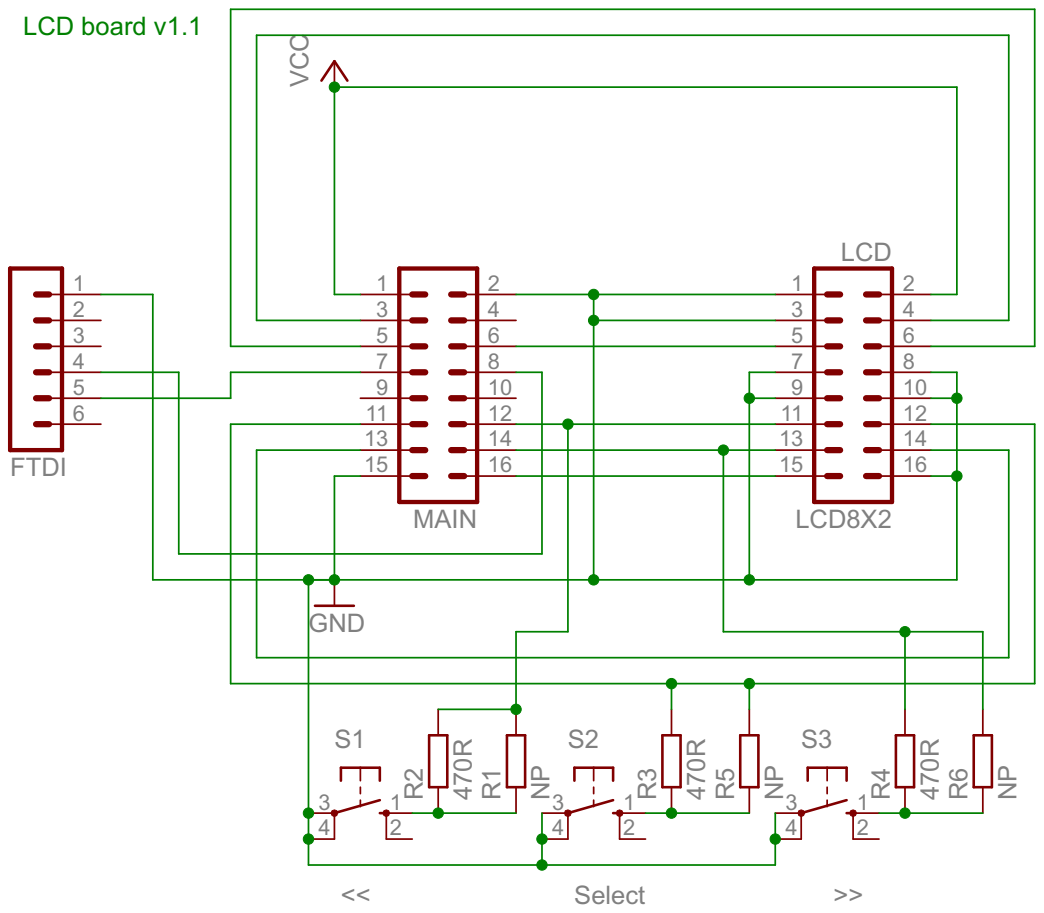
[picture p32: page 1]
