SmartEVSE/smartevse/eagle/3PCurrentTX.pdf

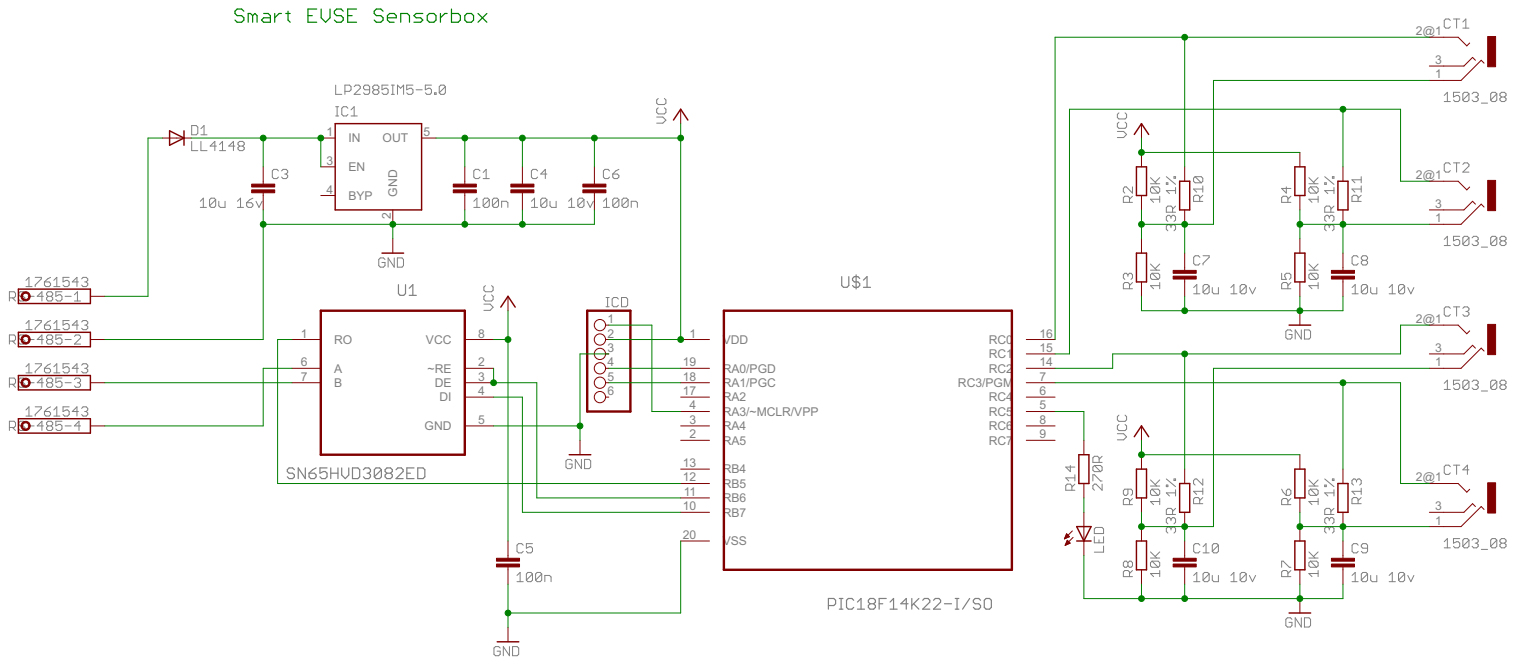
[picture p33: page 1]
