SmartEVSE/smartevse/version2/eagle/SmartEVSEv2.2.brd

## EAGLE design version2/eagle/SmartEVSEv2.2.brd (2019-11-08)

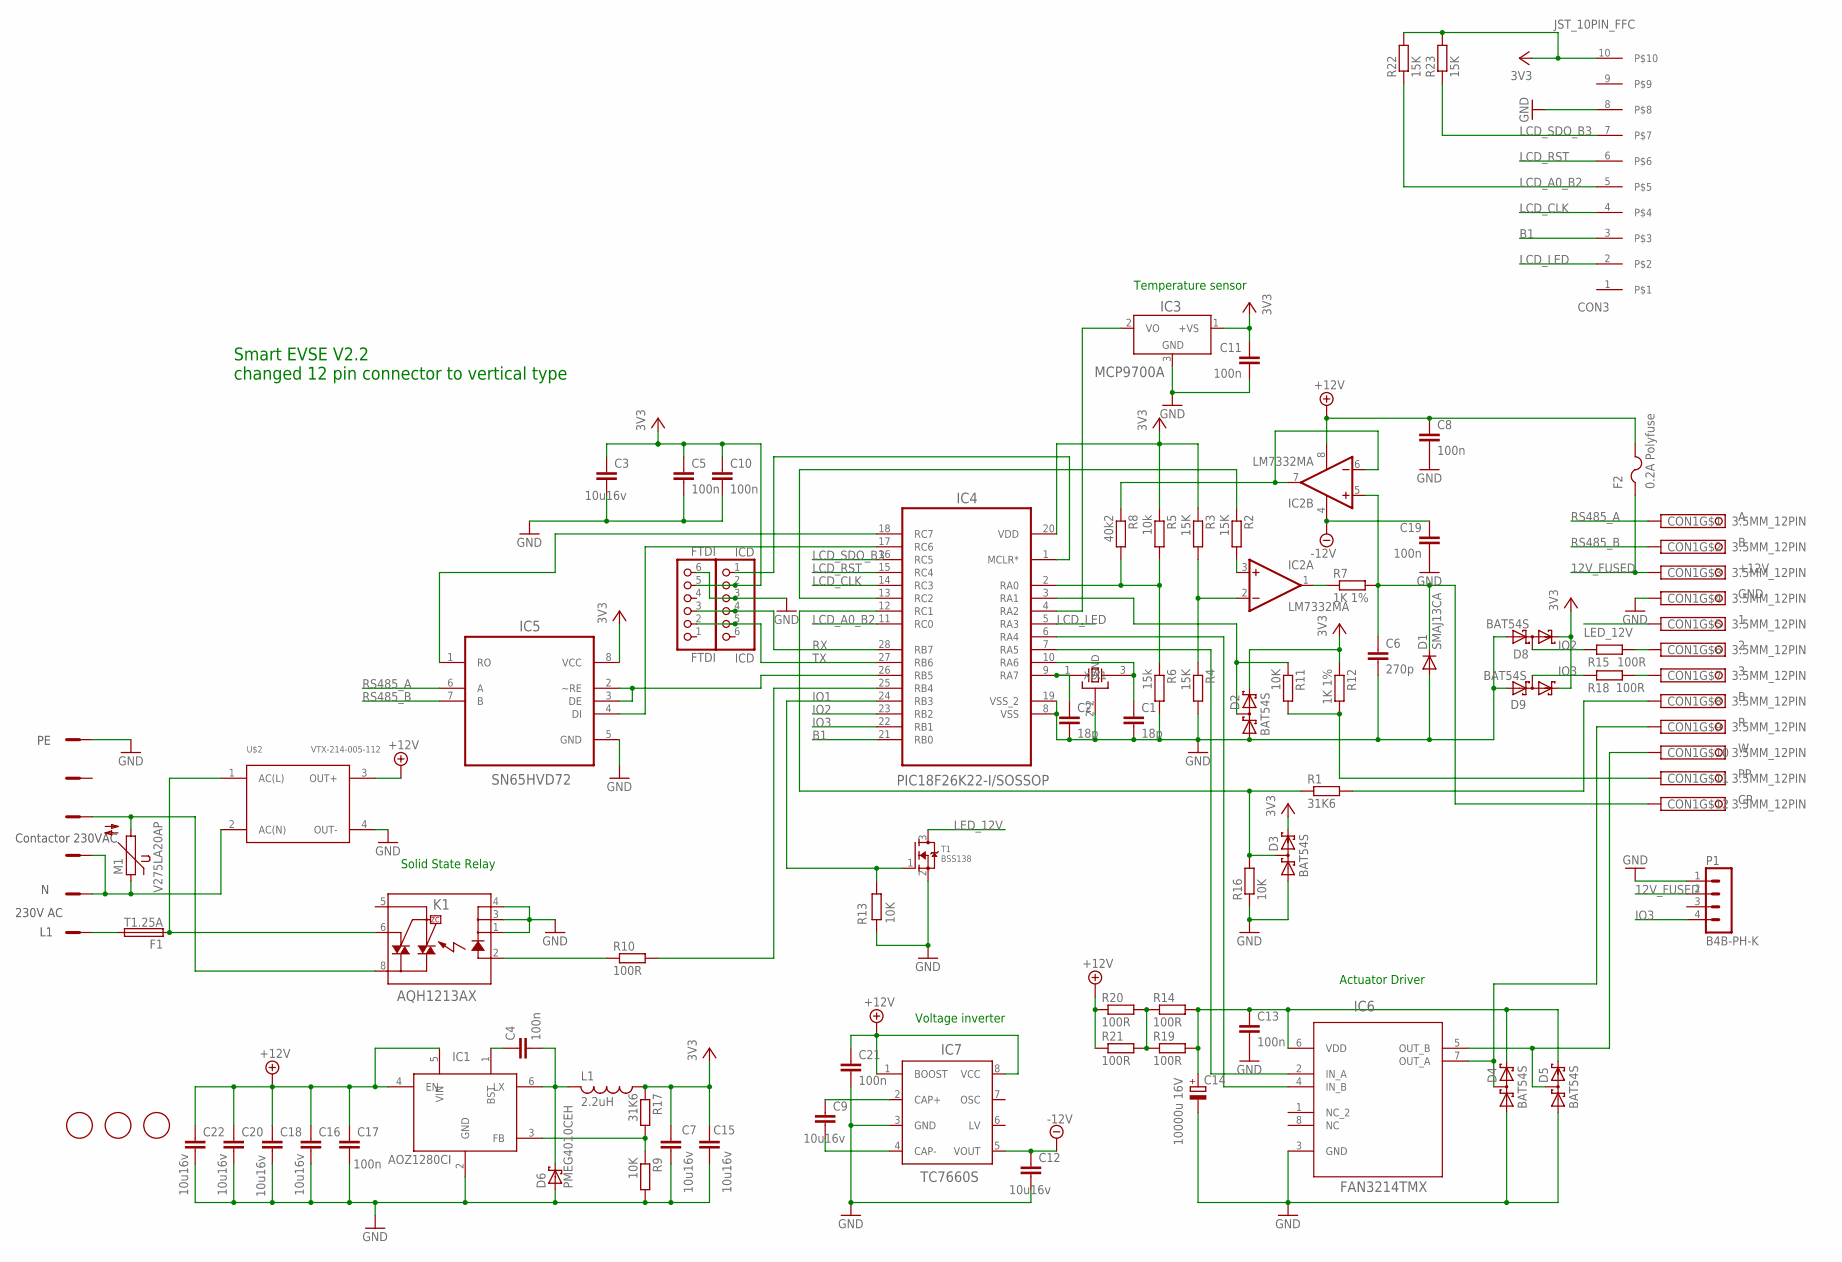
[picture p34: schematic SmartEVSEv2.2.sch]

Parts:
C1, C2: 18p; C0603
C3, C7, C9, C12, C15, C16, C18, C20, C22: 10u16v; C0805
C4, C5, C8, C10, C11, C13, C17, C19, C21: 100n; C0603
C6: 270p; C0805
C14: 10000u 16V; EB22,5D
CON1: 3.5MM_12PIN; 12PIN
CON2: DG128-7.5; P_AST027-06
CON3: JST_10PIN_FFC
D1: SMAJ13CA; DO214AC
D2, D3, D4, D5, D8, D9: BAT54S; SOT23
D6: PMEG4010CEH; SOD-123FL
F1: T1.25A; TE5
F2: 0.2A Polyfuse; R1210
FTDI: FTDI; 1X06-BIGLOCK
IC1: AOZ1280CI; SOT23-6
IC2: LM7332MA; SO08
IC3: MCP9700A; SOT23
IC4: PIC18F26K22-I/SOSSOP; SOP65P780X200-28N
IC5: SN65HVD72; SOIC127P600X175-8N
IC6: FAN3214TMX; SOIC127P600X175-8N
IC7: TC7660S; SO08
ICD: ICD; 1X06
K1: AQH1213AX; DIL07SMD
L1: 2.2uH; MCSD43
M1: V275LA20AP; S14K40
P1: B4B-PH-K
Q1: CTS_32X25_SMD; CTS_32X25
R1, R17: 31K6; R0603
R2, R3, R4, R22, R23: 15K; R0603
R5: 10k; R0603
R6: 15k; R0603
R7, R12: 1K 1%; R0603
R8: 40k2; R0603
R9, R11, R13, R16: 10K; R0603
R10, R14, R15, R18, R19, R20, R21: 100R; R0603
T1: BSS138; SOT23
U$1, U$3, U$4: FIDUCIAL; FIDUCIAL_1MM
U$2: VTX-214-005-112

Connections:
12V_FUSED: CON1.3, F2.1, P1.2
+12V: C8.1, C16.1, C17.1, C18.1, C20.1, C21.1, C22.1, F2.2, IC1.4 (EN), IC1.5 (VIN), IC2.8 (V+), IC7.1 (BOOST), IC7.8 (VCC), R20.1, R21.1, U$2.3 (OUT+)
-12V: C12.1, C19.1, IC2.4 (V-), IC7.5 (VOUT)
B1: CON3.3, IC4.21 (RB0)
GND: C1.2, C2.2, C3.2, C5.2, C6.2, C7.1, C8.2, C10.2, C11.2, C12.2, C13.2, C14.-, C15.1, C16.2, C17.2, C18.2, C19.2, C20.2, C21.2, C22.2, CON1.4, CON2.P$6, CON3.8, D1.A, D2.1 (A1), D3.1 (A1), D4.1 (A1), D5.1 (A1), D6.A, D8.1 (A1), D9.1 (A1), FTDI.6, IC1.2 (GND), IC3.3 (GND), IC4.8 (VSS), IC4.19 (VSS_2), IC5.5 (GND), IC6.3 (GND), IC7.3 (GND), ICD.3, K1.1 (K), K1.3 (K1), K1.4 (K2), P1.1, Q1.2 (GND), Q1.4 (GND), R4.2, R6.2, R9.2, R13.1, R16.1, T1.2 (S), U$2.4 (OUT-)
IO1: IC4.24 (RB3), R13.2, T1.1 (G)
IO2: D8.3 (C1A2), IC4.23 (RB2), R15.1
IO3: D9.3 (C1A2), IC4.22 (RB1), P1.4, R18.1
LCD_A0_B2: CON3.5, IC4.11 (RC0), R22.1
LCD_CLK: CON3.4, IC4.14 (RC3)
LCD_LED: CON3.2, IC4.5 (RA3)
LCD_RST: CON3.6, IC4.15 (RC4)
LCD_SDO_B3: CON3.7, IC4.16 (RC5), R23.1
LED_12V: CON1.5, T1.3 (D)
unnamed: D3.3 (C1A2), IC4.12 (RC1), R1.1, R16.2
unnamed: F1.1, K1.6 (DS3), U$2.1 (AC(L))
unnamed: IC4.6 (RA4), IC6.4 (IN_B)
unnamed: IC4.17 (RC6), IC5.4 (DI)
unnamed: IC4.18 (RC7), IC5.1 (RO)
unnamed: C2.1, IC4.9 (RA7), Q1.1 (X1)
unnamed: C1.1, IC4.10 (RA6), Q1.3 (X2)
unnamed: IC2.2 (-IN), R3.2, R4.1
unnamed: C6.1, CON1.12, D1.C, IC2.5 (+IN), R7.2
unnamed: IC4.13 (RC2), R2.1
unnamed: IC2.3 (+IN), R2.2
unnamed: IC4.2 (RA0), R5.2, R6.1, R8.2
unnamed: IC2.1 (OUT), R7.1
unnamed: IC2.6 (-IN), IC2.7 (OUT), R8.1
unnamed: D2.3 (C1A2), IC4.3 (RA1), R11.1
unnamed: C13.1, C14.+, D4.2 (C2), D5.2 (C2), IC6.6 (VDD), R14.2, R19.2
unnamed: IC4.7 (RA5), IC6.2 (IN_A)
unnamed: K1.2 (A), R10.1
unnamed: IC4.25 (RB4), R10.2
unnamed: CON2.P$1, F1.2
unnamed: CON1.11, R11.2, R12.2
unnamed: CON2.P$4, K1.8 (DS1), M1.2
unnamed: IC4.26 (RB5), IC5.2 (~RE), IC5.3 (DE)
unnamed: CON2.P$2, CON2.P$3, M1.1, U$2.2 (AC(N))
unnamed: CON1.9, D4.3 (C1A2), IC6.7 (OUT_A)
unnamed: IC4.1 (MCLR*), ICD.1
unnamed: CON1.10, D5.3 (C1A2), IC6.5 (OUT_B)
unnamed: C4.1, IC1.1 (BST)
unnamed: R14.1, R19.1, R20.2, R21.2
unnamed: CON1.8, R1.2
unnamed: CON1.6, R15.2
unnamed: CON1.7, R18.2
unnamed: C9.1, IC7.2 (CAP+)
unnamed: IC3.2 (VO), IC4.4 (RA2)
unnamed: C9.2, IC7.4 (CAP-)
unnamed: IC1.3 (FB), R9.1, R17.2
unnamed: C4.2, D6.C, IC1.6 (LX), L1.2
RS485_A: CON1.1, IC5.6 (A)
RS485_B: CON1.2, IC5.7 (B)
RX: FTDI.3, IC4.28 (RB7), ICD.4
TX: FTDI.2, IC4.27 (RB6), ICD.5
VCC: C3.1, C5.1, C7.2, C10.1, C11.1, C15.2, CON3.10, D2.2 (C2), D3.2 (C2), D8.2 (C2), D9.2 (C2), FTDI.5, IC3.1 (+VS), IC4.20 (VDD), IC5.8 (VCC), ICD.2, L1.1, R3.1, R5.1, R12.1, R17.1, R22.2, R23.2

Notes on the sheet:
230V AC
Contactor 230VAC
Smart EVSE V2.2 changed 12 pin connector to vertical type
Temperature sensor
Actuator Driver
Solid State Relay
Voltage inverter
GND
+12V

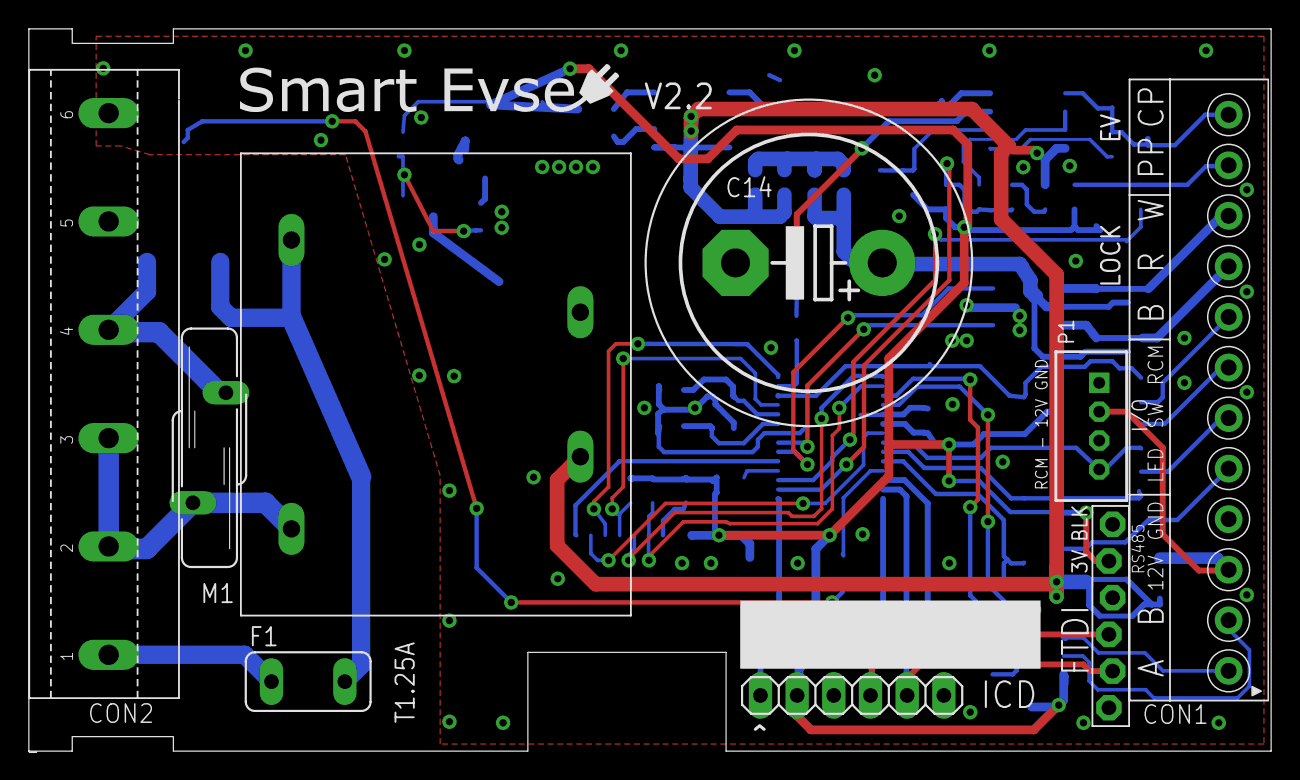
[picture p35: board SmartEVSEv2.2.brd from above]

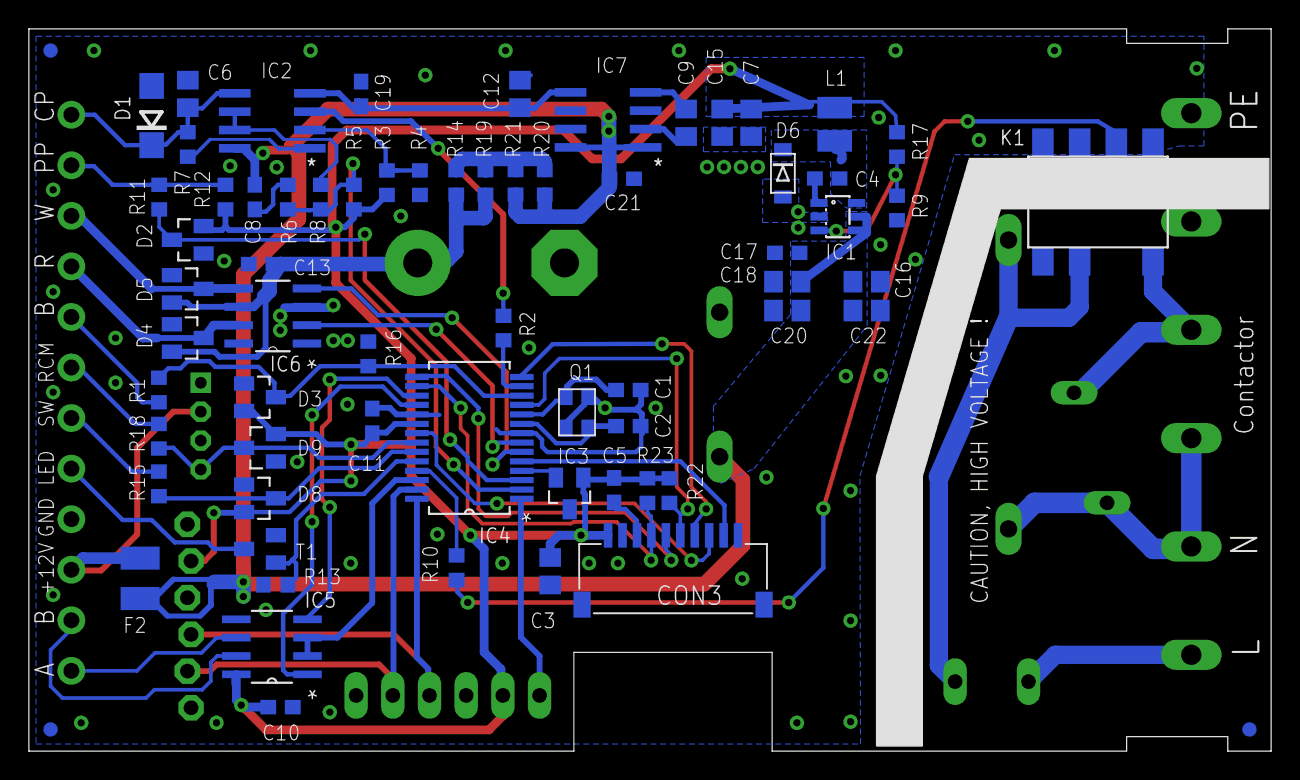
[picture p36: board SmartEVSEv2.2.brd from below]

Board: 2 copper layers, 86.0 x 50.0 mm, 77 parts (68 on the bottom side), 56 nets.
