SmartEVSE/smartevse/version2/eagle/LCD_boardv2.brd

## EAGLE design version2/eagle/LCD_boardv2.brd (2017-08-28)

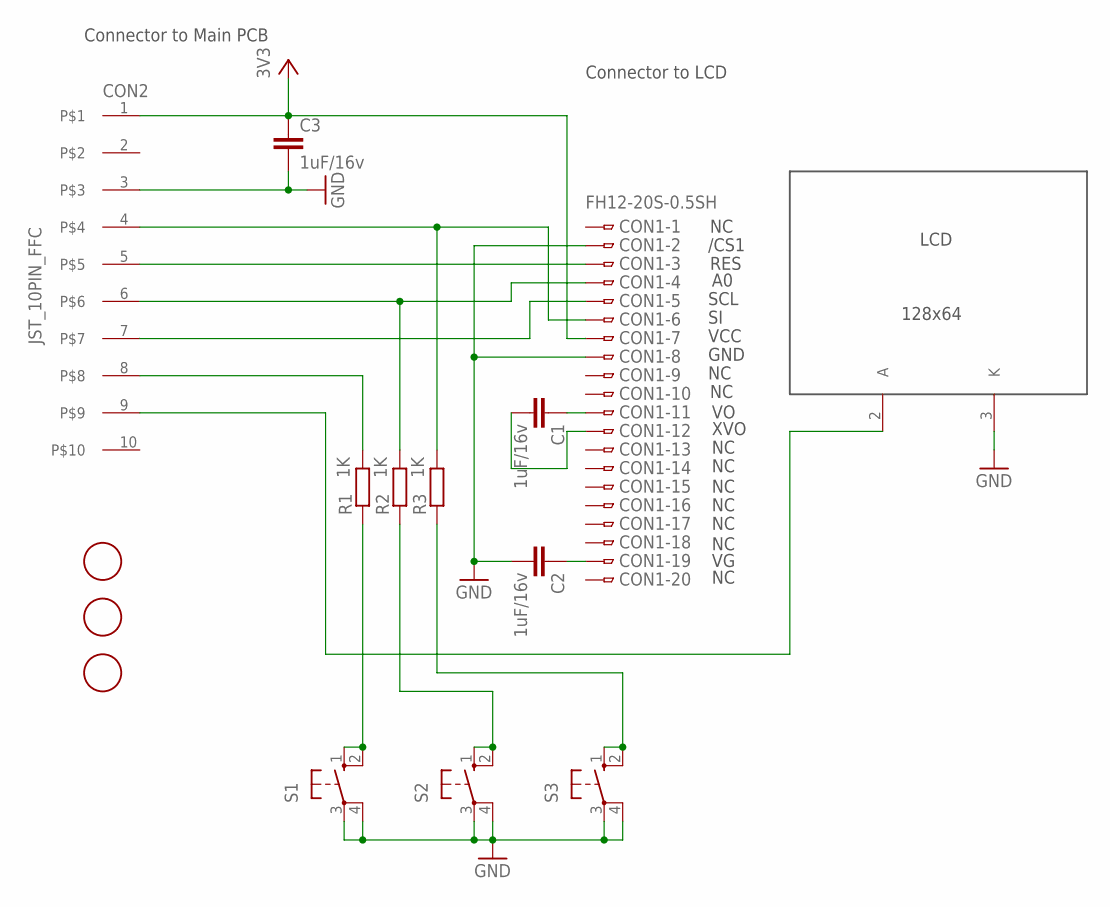
[picture p37: schematic LCD_boardv2.sch]

Parts:
C1, C2, C3: 1uF/16v; C0805
CON1: FH12-20S-0.5SH
CON2: JST_10PIN_FFC
R1, R2, R3: 1K; R0603
S1, S2, S3: 10-XX; B3F-10XX
U$1: LCD_DEM128064
U$2, U$3, U$4: FIDUCIAL; FIDUCIAL_1MM

Connections:
GND: C2.2, C3.2, CON1.2, CON1.8, CON2.3, S1.3, S1.4 (P1), S2.3, S2.4 (P1), S3.3, S3.4 (P1), U$1.3 (K)
unnamed: C1.1, CON1.11
unnamed: C1.2, CON1.12
unnamed: C2.1, CON1.19
unnamed: CON1.6, CON2.4, R3.2
unnamed: CON1.3, CON2.5
unnamed: CON1.4, CON2.6, R2.2
unnamed: CON1.5, CON2.7
unnamed: R1.1, S1.1 (S), S1.2 (S1)
unnamed: CON2.9, U$1.2 (A)
unnamed: R2.1, S2.1 (S), S2.2 (S1)
unnamed: CON2.8, R1.2
unnamed: R3.1, S3.1 (S), S3.2 (S1)
VCC: C3.1, CON1.7, CON2.1

Notes on the sheet:
/CS1
RES
SCL
VCC
GND
XVO
Connector to Main PCB
Connector to LCD

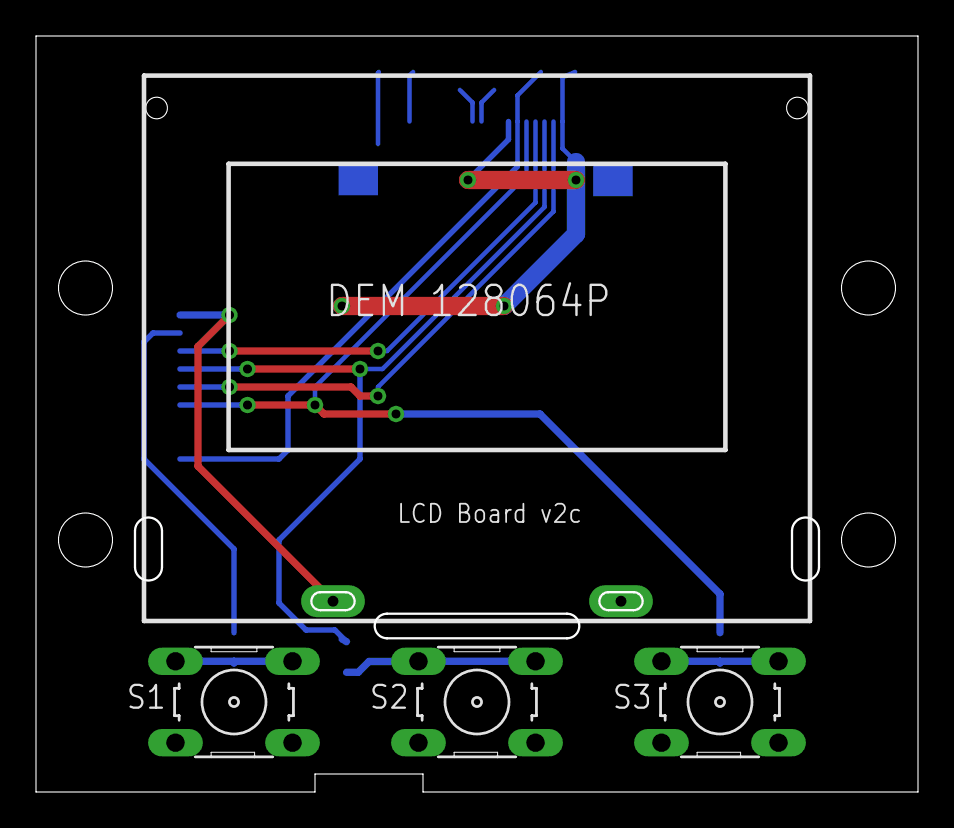
[picture p38: board LCD_boardv2.brd from above]

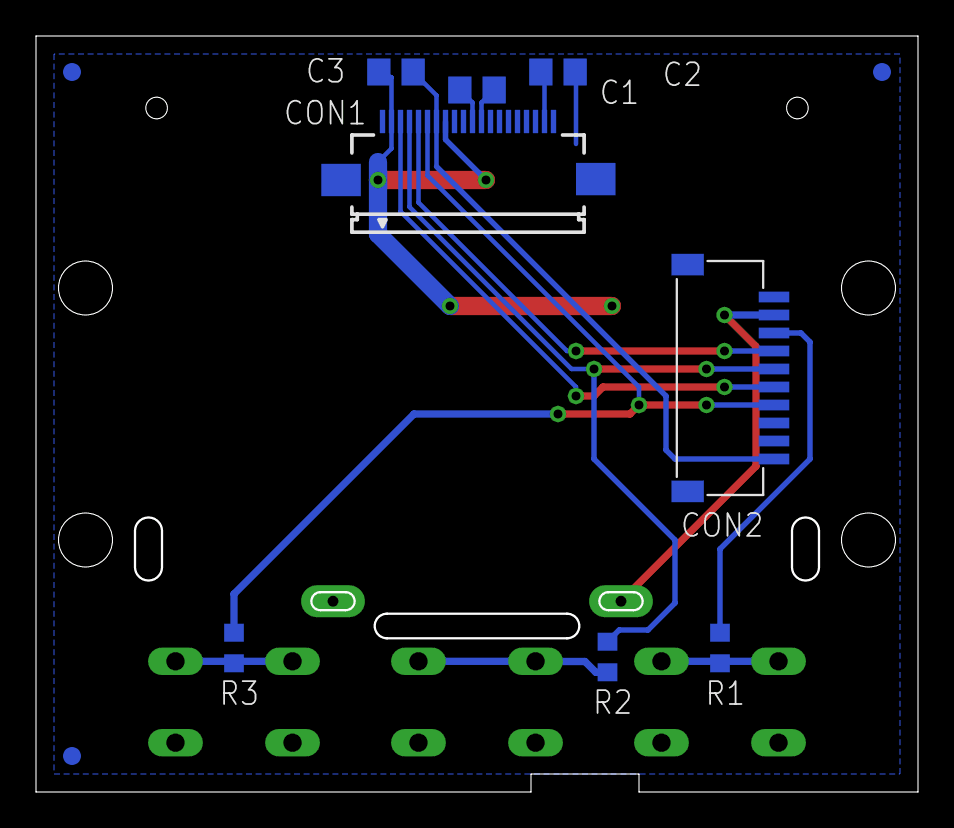
[picture p39: board LCD_boardv2.brd from below]

Board: 2 copper layers, 49.0 x 42.0 mm, 15 parts (11 on the bottom side), 14 nets.
