SmartEVSE/smartevse/eagle/LCD_board.brd

## EAGLE design eagle/LCD_board.brd (2016-03-04)

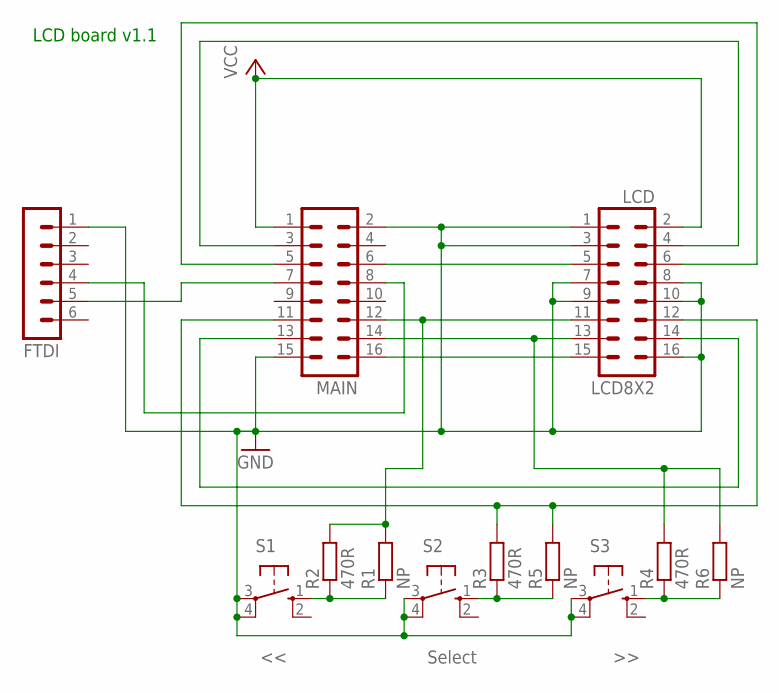
[picture p43: schematic LCD_board.sch]

Parts:
FTDI: MA06-1
LCD8X2: LCD; MA08-2
MAIN: MA08-2
R1, R5, R6: NP; 0204/7
R2, R3, R4: 470R; R0805
S1: <<; B3F-10XX
S2: Select; B3F-10XX
S3: >>; B3F-10XX

Connections:
GND: FTDI.1, LCD8X2.1, LCD8X2.3, LCD8X2.7, LCD8X2.8, LCD8X2.9, LCD8X2.10, LCD8X2.16, MAIN.2, MAIN.15, S1.3, S1.4 (P1), S2.3, S2.4 (P1), S3.3, S3.4 (P1)
unnamed: FTDI.5, MAIN.7
unnamed: LCD8X2.15, MAIN.16
unnamed: LCD8X2.13, MAIN.14, R4.2, R6.2
unnamed: LCD8X2.11, MAIN.12, R1.2, R2.2
unnamed: LCD8X2.14, MAIN.13
unnamed: LCD8X2.12, MAIN.11, R3.2, R5.2
unnamed: LCD8X2.5, MAIN.6
unnamed: LCD8X2.6, MAIN.5
unnamed: LCD8X2.4, MAIN.3
unnamed: FTDI.4, MAIN.8
unnamed: R1.1, R2.1, S1.1 (S)
unnamed: R3.1, R5.1, S2.1 (S)
unnamed: R4.1, R6.1, S3.1 (S)
VCC: LCD8X2.2, MAIN.1

Notes on the sheet:
LCD board v1.1

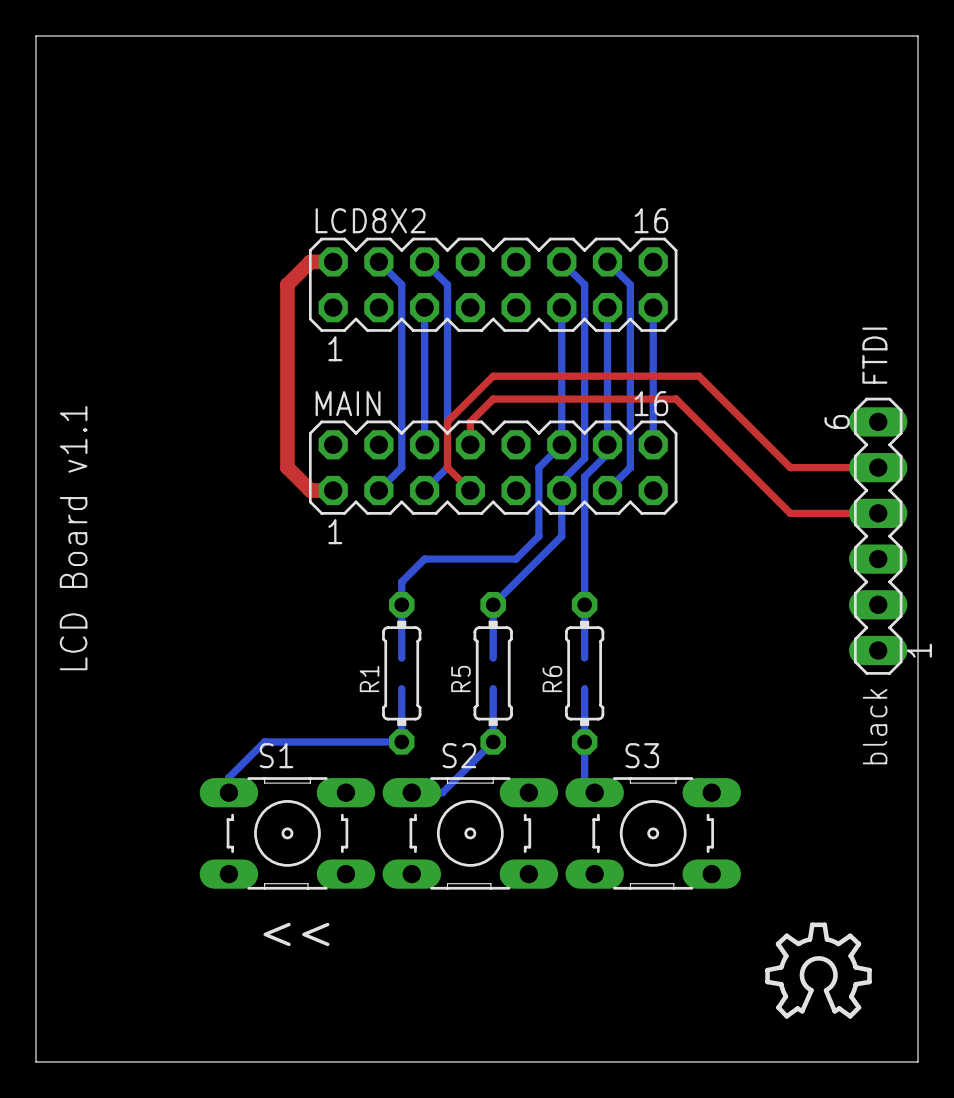
[picture p44: board LCD_board.brd from above]

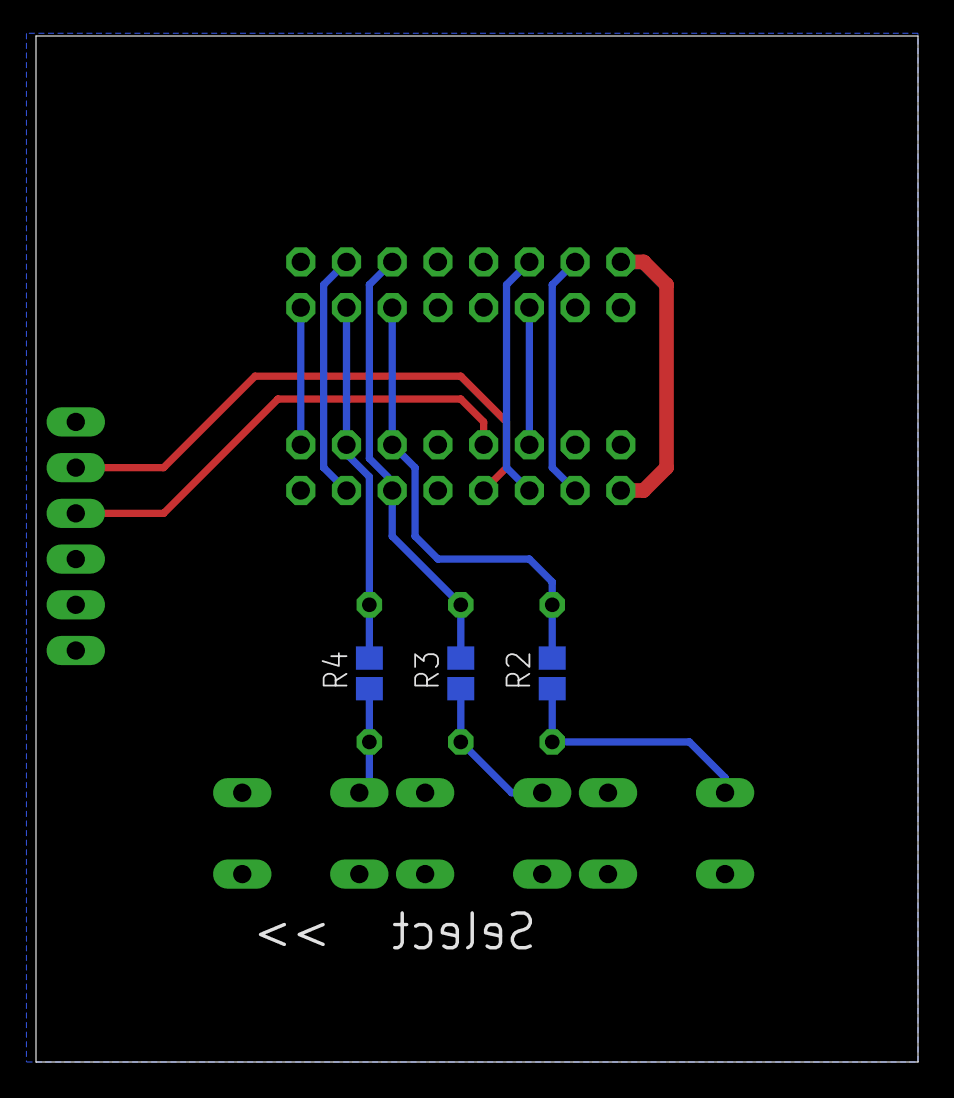
[picture p45: board LCD_board.brd from below]

Board: 2 copper layers, 49.0 x 57.0 mm, 13 parts (3 on the bottom side), 15 nets.

Other parts of the board:
U$1: OSHW_10X200_NOTEXT
